J-Jappa/currawong/docs/media/photos/front-closeup.jpg

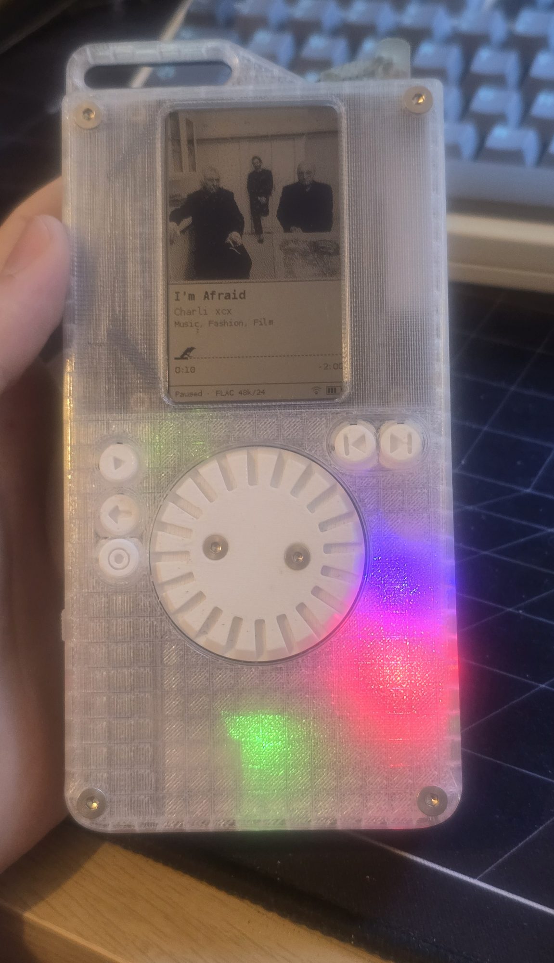
docs/media/photos/front-closeup.jpg
