J-Jappa/currawong/docs/media/photos/pcb-bare-front.jpg

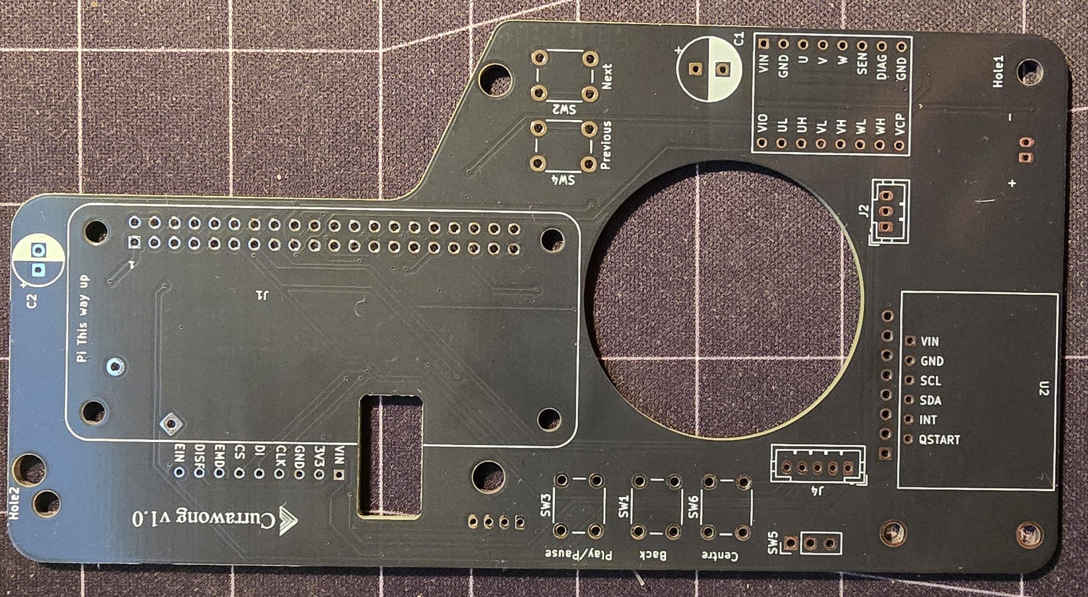
docs/media/photos/pcb-bare-front.jpg
