J-Jappa/currawong/pi/assets/branch_sway.png

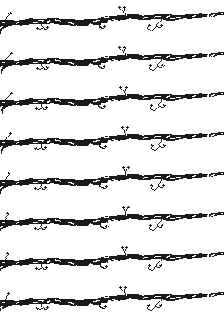
pi/assets/branch_sway.png
