J-Jappa/currawong/pi/assets/currawong_sheet.png

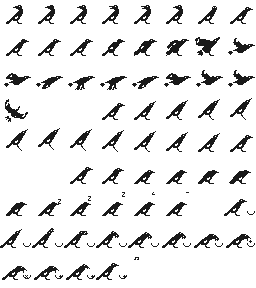
pi/assets/currawong_sheet.png
