J-Jappa/currawong/hardware/case/stl/Back Case v4.STL

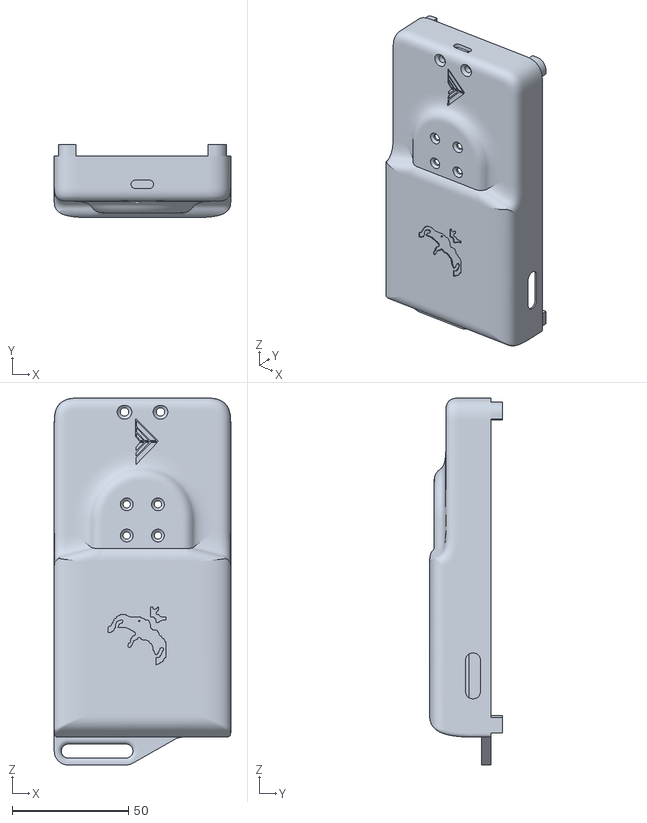
[picture p21: CAD file, 2026-10-29]
hardware/case/stl/Back Case v4.STL
76.0 x 31.4 x 158.0
