J-Jappa/currawong/hardware/logos/currawong-icon-x4.dxf

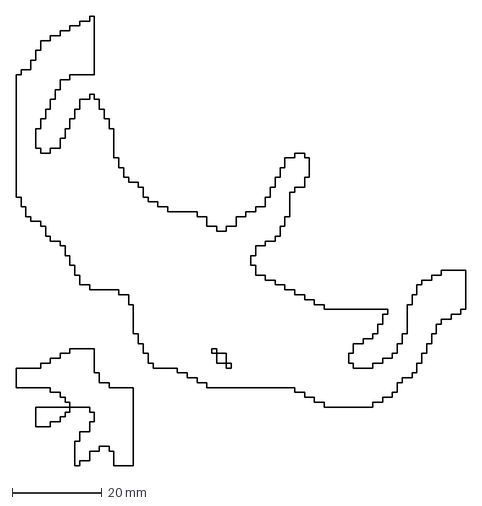
[picture p22: CAD file, 2026-10-29]
hardware/logos/currawong-icon-x4.dxf
100.0 x 100.0 mm
