J-Jappa/currawong/hardware/pcb/Currawong-v1.0.step

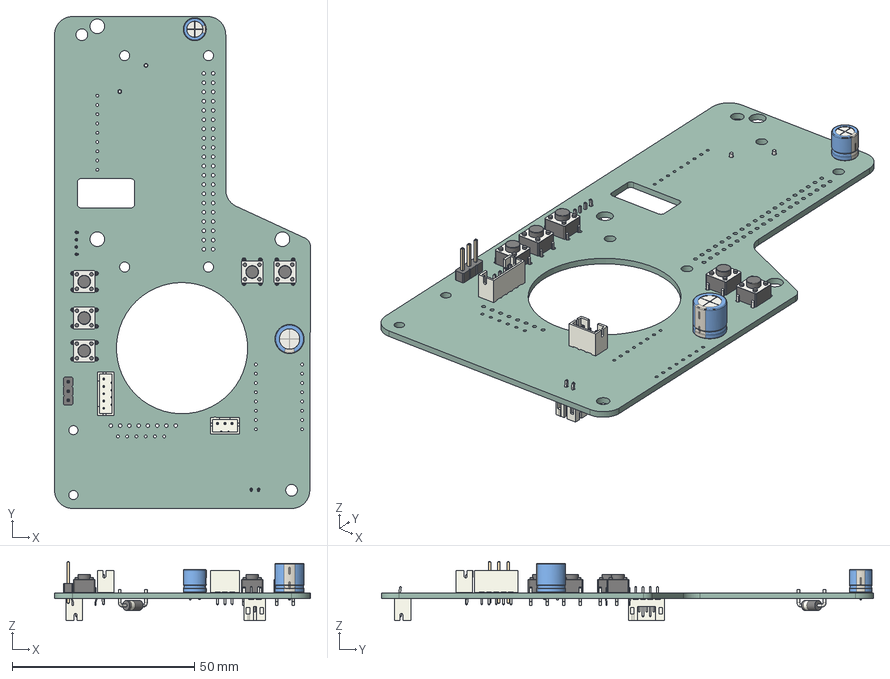
[picture p23: CAD file, 2026-10-29]
hardware/pcb/Currawong-v1.0.step
70.2 x 135.0 x 16.2 mm
SW_PUSH_6mm_h5mm x 5
JST_B5B_PH_K
CP_Radial_D63mm_P250mm
JST_B3B_PH_K
PinHeader_1x03_P254mm_Vertical
CP_Radial_D80mm_P350mm
D_DO-41_SOD81_P10.16mm_Horizontal
JST_B2B_PH_K
JST_B4B_PH_K
Cur1A55_PCB
