J-Jappa/currawong/hardware/case/solidworks/Button Center.SLDPRT

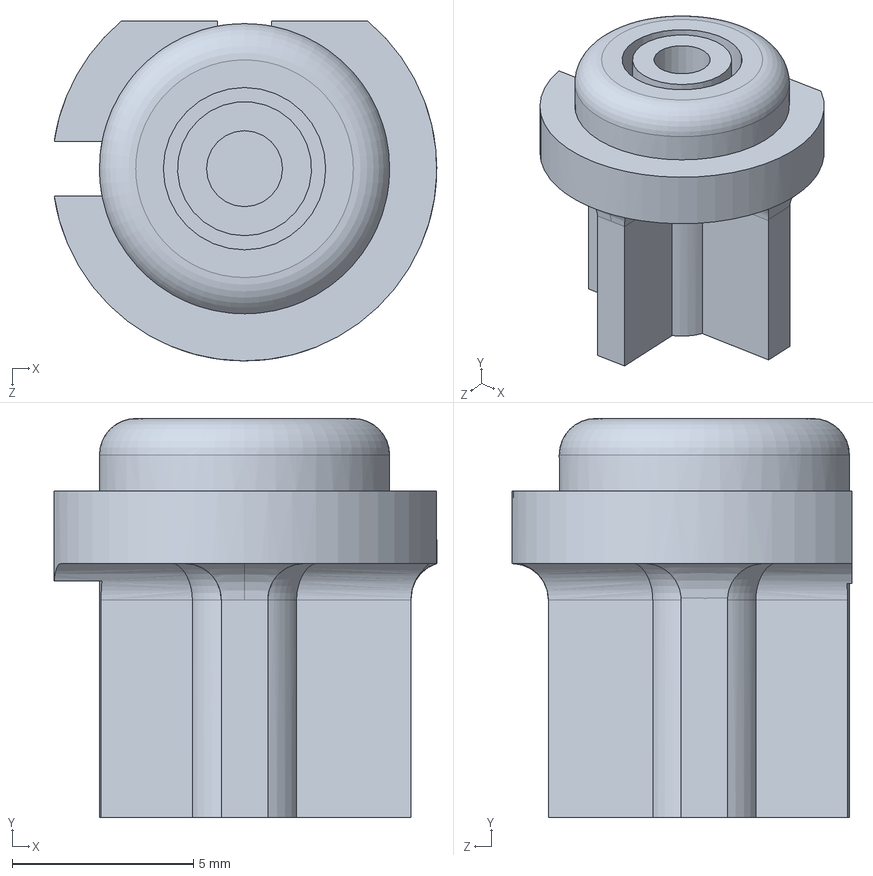
[picture p24: CAD file, 2026-10-29]
hardware/case/solidworks/Button Center.SLDPRT
10.5 x 11.0 x 9.37 mm
