J-Jappa/currawong/hardware/logos/personal-mark.dxf

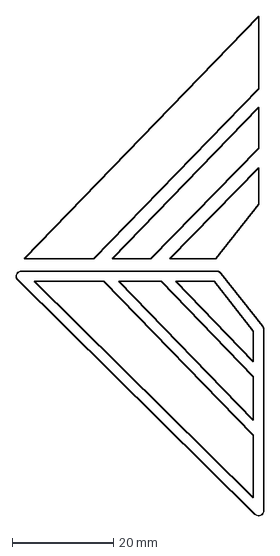
[picture p25: CAD file, 2026-10-29]
hardware/logos/personal-mark.dxf
48.8 x 98.4 mm
