J-Jappa/currawong/hardware/logos/currawong-icon-x2.dxf

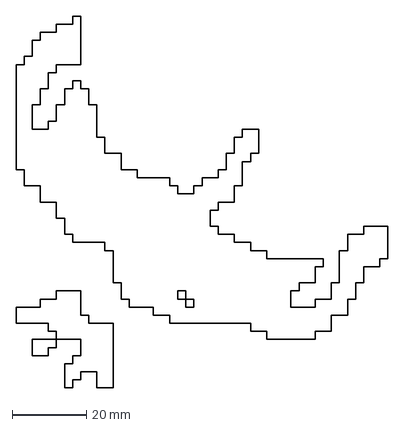
[picture p26: CAD file, 2026-10-29]
hardware/logos/currawong-icon-x2.dxf
100.0 x 100.0 mm
