J-Jappa/currawong/hardware/case/solidworks/Front Case v3.SLDPRT

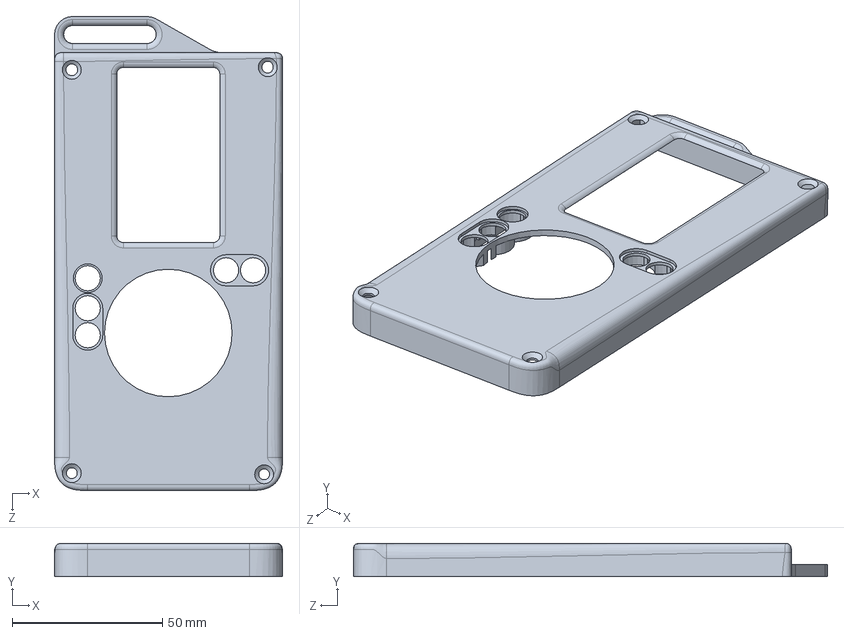
[picture p27: CAD file, 2026-10-29]
hardware/case/solidworks/Front Case v3.SLDPRT
76.0 x 11.0 x 158.0 mm
