J-Jappa/currawong/hardware/case/solidworks/Dial v2.SLDPRT

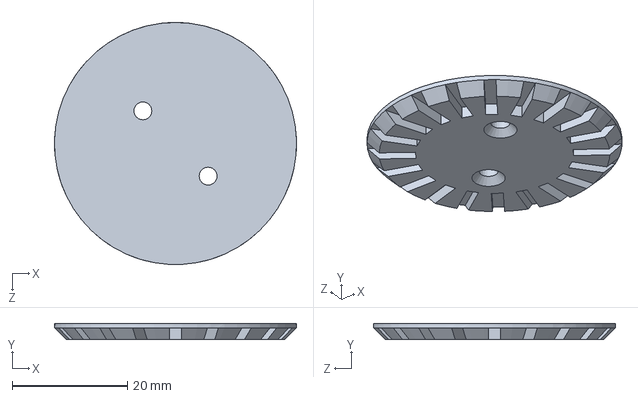
[picture p28: CAD file, 2026-10-29]
hardware/case/solidworks/Dial v2.SLDPRT
42.0 x 2.80 x 42.0 mm
