J-Jappa/currawong/hardware/case/solidworks/Button Next.SLDPRT

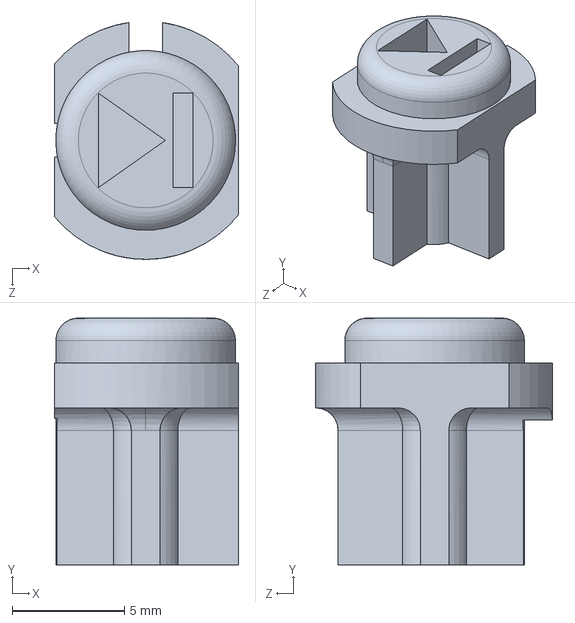
[picture p29: CAD file, 2026-10-29]
hardware/case/solidworks/Button Next.SLDPRT
8.21 x 11.0 x 10.5 mm
