J-Jappa/currawong/hardware/case/solidworks/Battery.SLDPRT

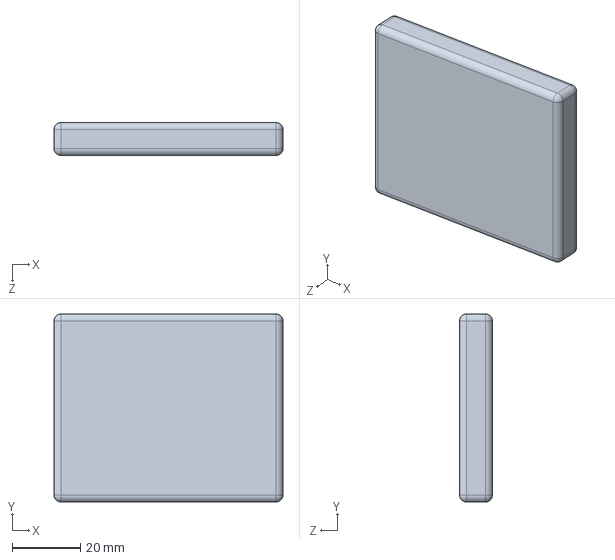
[picture p30: CAD file, 2026-10-29]
hardware/case/solidworks/Battery.SLDPRT
67.0 x 55.0 x 9.60 mm
