J-Jappa/currawong/hardware/case/solidworks/Display.SLDPRT

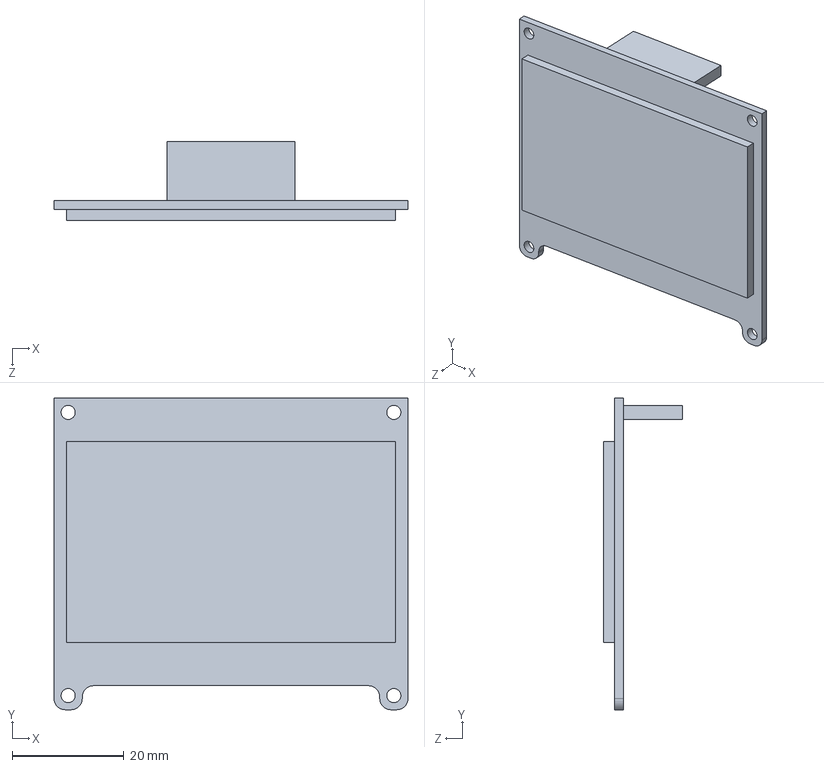
[picture p31: CAD file, 2026-10-29]
hardware/case/solidworks/Display.SLDPRT
63.5 x 55.9 x 14.3 mm
