J-Jappa/currawong/hardware/case/solidworks/Button Play.SLDPRT

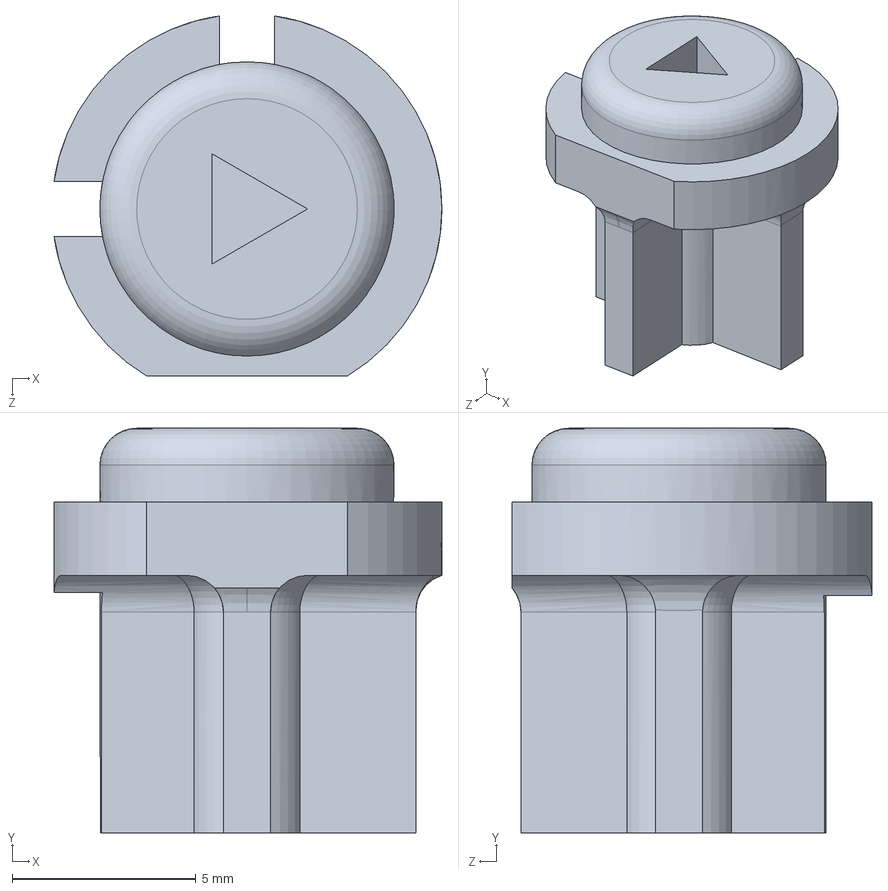
[picture p32: CAD file, 2026-10-29]
hardware/case/solidworks/Button Play.SLDPRT
10.5 x 11.0 x 9.79 mm
