J-Jappa/currawong/hardware/case/solidworks/Dac.SLDPRT

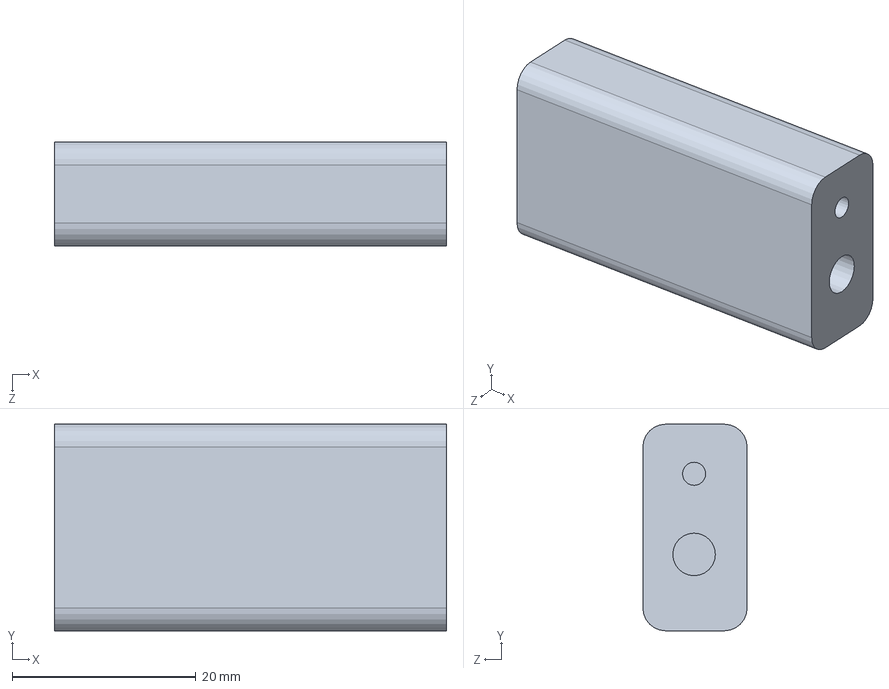
[picture p33: CAD file, 2026-10-29]
hardware/case/solidworks/Dac.SLDPRT
42.7 x 22.5 x 11.4 mm
