J-Jappa/currawong/hardware/case/solidworks/Slide Switch.SLDPRT

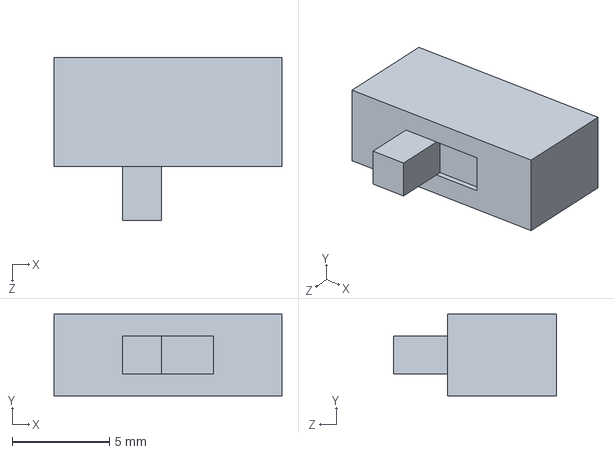
[picture p34: CAD file, 2026-10-29]
hardware/case/solidworks/Slide Switch.SLDPRT
11.7 x 4.20 x 8.36 mm
