J-Jappa/currawong/hardware/case/solidworks/Bad Slide Fix.SLDPRT

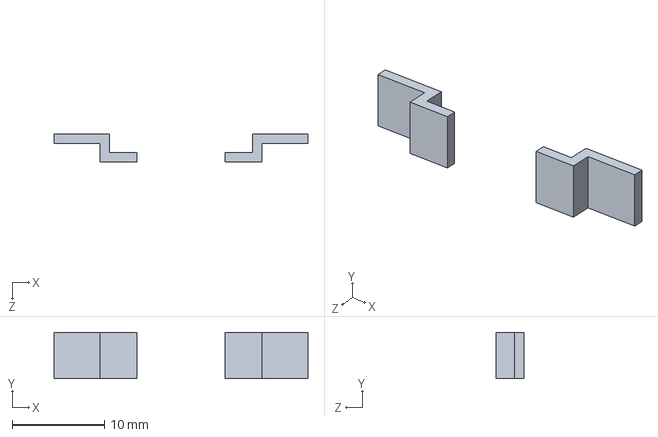
[picture p35: CAD file, 2026-10-29]
hardware/case/solidworks/Bad Slide Fix.SLDPRT
27.5 x 5.00 x 3.00 mm
