J-Jappa/currawong/hardware/case/solidworks/Button Back.SLDPRT

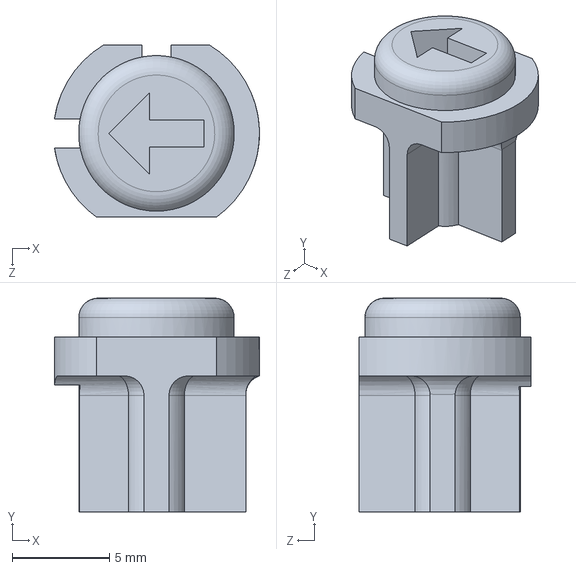
[picture p36: CAD file, 2026-10-29]
hardware/case/solidworks/Button Back.SLDPRT
10.5 x 11.0 x 8.84 mm
