J-Jappa/currawong/hardware/case/solidworks/Slide.SLDPRT

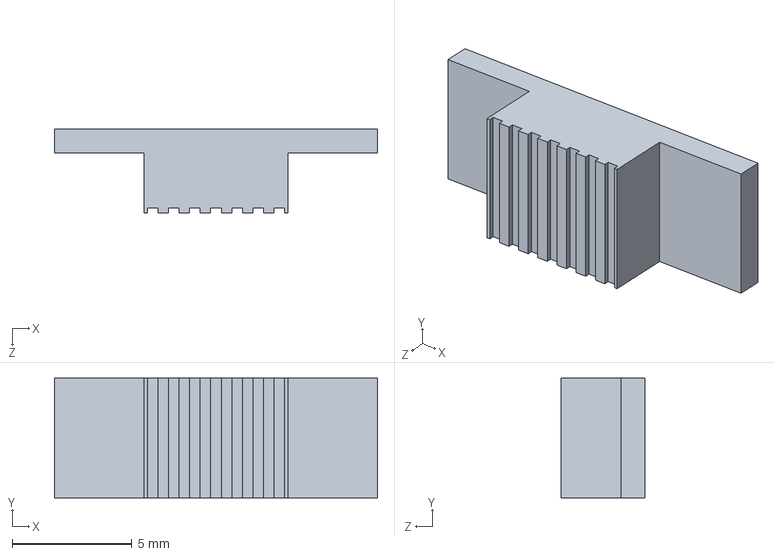
[picture p37: CAD file, 2026-10-29]
hardware/case/solidworks/Slide.SLDPRT
13.5 x 5.00 x 3.50 mm
