J-Jappa/currawong/hardware/case/solidworks/Currawong assembly.SLDASM

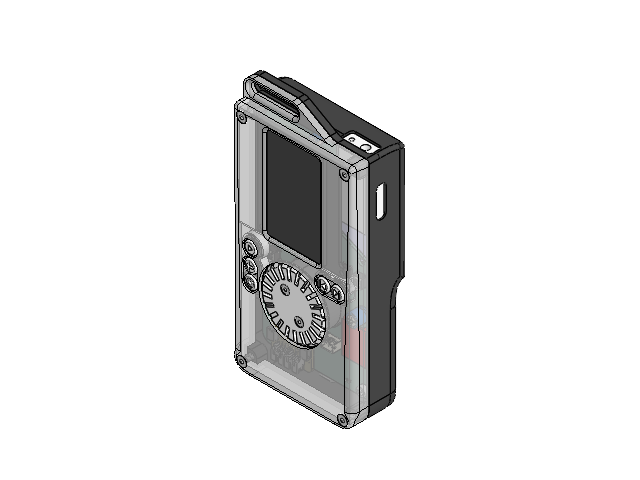
[picture p38: CAD file, 2026-10-29]
hardware/case/solidworks/Currawong assembly.SLDASM
SW_PUSH_6mm_h5mm_1.step x 5
JST_B5B_PH_K.step
CP_Radial_D63mm_P250mm.step
JST_B3B_PH_K.step
CP_Radial_D80mm_P350mm.step
D_DO-41_SOD81_P10.16mm_Horizontal-0.step
JST_B2B_PH_K.step
JST_B4B_PH_K.step
Cur1A55_PCB.step
Display
铜柱M2.5x7+4.STEP x 8
直流无刷电机HTY2804D3.STEP
AS5600磁编码器.STEP
Dial v2
Battery
Dac
Back Case v2
USB Breakout
Front Case v3
Button Play
Button Back
Button Center
Button Next
Button Previous
Slide Switch
Slide
Raspberry_pizero_PCB
Micro USB_input_female (short)-SMT x 2
0204 - Capacitor x 34
0204- Resistor x 17
CAP-0306 x 2
Raspberry_pizero_BCM2835 with VC4
Crystal 3.4x2.4mm
32,768 Khz Crystal
0805- Capacitor x 7
0204 - Capacitor Brown x 8
6-Pin SOT
micro sd molex
hdmi type C
Voltage Regulator 3x3mm 12-Pin
1210 inductor x 3
BOSS-EXTRUDE14_8__2.step
BOSS-EXTRUDE7_4__2.step
BOSS-EXTRUDE7_3__2.step
BOSS-EXTRUDE14_4__2.step
BOSS-EXTRUDE14_2__2.step
BOSS-EXTRUDE14_11__2.step
BOSS-EXTRUDE7_7__2.step
BOSS-EXTRUDE14_9__2.step
BOSS-EXTRUDE14_3__2.step
BOSS-EXTRUDE14_7__2.step
MIRROR2_2.step
BOSS-EXTRUDE14_5__2.step
BOSS-EXTRUDE14_12__2.step
BOSS-EXTRUDE7_8__2.step
BOSS-EXTRUDE7_1__2.step
BOSS-EXTRUDE14_10__2.step
BOSS-EXTRUDE7_9__2.step
BOSS-EXTRUDE14_6__2.step
CHAMFER9_2.step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
