J-Jappa/currawong/(list of files, cad)

Other CAD files:
hardware/case/solidworks/Back Case v2.SLDPRT
hardware/case/solidworks/Button Previous.SLDPRT
hardware/case/stl/Bad Slide Fix.STL
hardware/case/stl/Button Back.STL
hardware/case/stl/Button Center.STL
hardware/case/stl/Button Next.STL
hardware/case/stl/Button Play.STL
hardware/case/stl/Button Previous.STL
hardware/case/stl/Dial v2.STL
hardware/case/stl/Front Case v3.STL
hardware/case/stl/Slide.STL
