J-Jappa/currawong/hardware/pcb/Currawong.kicad_pcb

## KiCad design hardware/pcb/Currawong.kicad_pcb (2026-10-29)

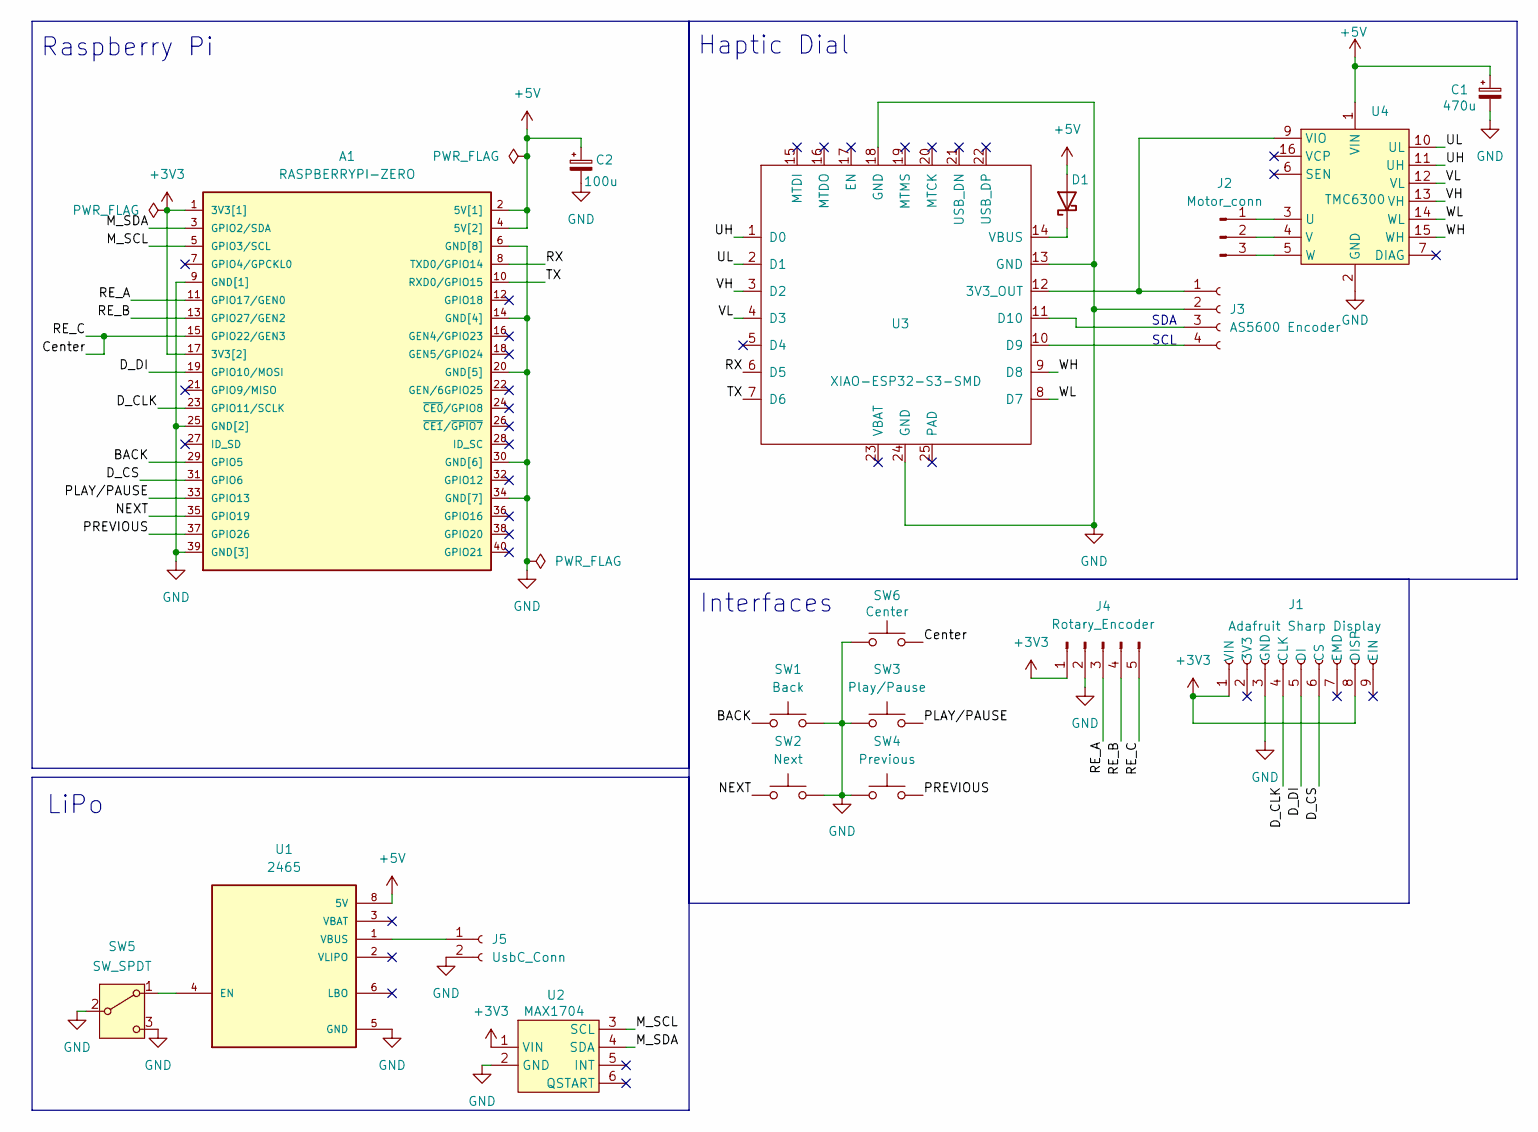
[picture p39: schematic Currawong.kicad_sch]

Parts:
A1: RASPBERRYPI-ZERO; RASPBERRYPI-ZERO_RPI-ZERO
C1: 470u; CP_Radial_D8.0mm_P3.50mm
C2: 100u; CP_Radial_D6.3mm_P2.50mm
D1: D_Schottky; D_DO-41_SOD81_P10.16mm_Horizontal
J1: Adafruit Sharp Display; Sharp_Display
J2: Motor_conn; JST_PH_B3B-PH-K_1x03_P2.00mm_Vertical
J3: AS5600 Encoder; JST_PH_B4B-PH-K_1x04_P2.00mm_Vertical
J4: Rotary_Encoder; JST_PH_B5B-PH-K_1x05_P2.00mm_Vertical
J5: UsbC_Conn; JST_PH_B2B-PH-K_1x02_P2.00mm_Vertical
SW1: Back; SW_PUSH_6mm_H5mm
SW2: Next; SW_PUSH_6mm_H5mm
SW3: Play/Pause; SW_PUSH_6mm_H5mm
SW4: Previous; SW_PUSH_6mm_H5mm
SW5: SW_SPDT; PinHeader_1x03_P2.54mm_Vertical
SW6: Center; SW_PUSH_6mm_H5mm
U1: 2465; MODULE_2465; PARTREV B
U2: MAX1704; AdaFruit_MAX17048
U3: XIAO-ESP32-S3-SMD
U4: TMC6300; Sparkfun_TMC6300

Connections:
+3V3: A1.1 (3V3[1]), A1.17 (3V3[2]), J1.1 (VIN), J1.8 (DISP), J4.1, U2.1 (VIN)
+5V: A1.2 (5V[1]), A1.4 (5V[2]), C1.1, C2.1, D1.2 (A), U1.8 (5V), U4.1 (VIN)
/BACK: A1.29 (GPIO5), SW1.1
/Center: A1.15 (GPIO22/GEN3), J4.5, SW6.2
/D_CLK: A1.23 (GPIO11/SCLK), J1.4 (CLK)
/D_CS: A1.31 (GPIO6), J1.6 (CS)
/D_DI: A1.19 (GPIO10/MOSI), J1.5 (DI)
/M_SCL: A1.5 (GPIO3/SCL), U2.3 (SCL)
/M_SDA: A1.3 (GPIO2/SDA), U2.4 (SDA)
/NEXT: A1.35 (GPIO19), SW2.1
/PLAY/PAUSE: A1.33 (GPIO13), SW3.2
/PREVIOUS: A1.37 (GPIO26), SW4.2
/RE_A: A1.11 (GPIO17/GEN0), J4.3
/RE_B: A1.13 (GPIO27/GEN2), J4.4
/RX: A1.8 (TXD0/GPIO14), U3.6 (D5)
/TX: A1.10 (RXD0/GPIO15), U3.7 (D6)
/UH: U3.1 (D0), U4.11 (UH)
/UL: U3.2 (D1), U4.10 (UL)
/VH: U3.3 (D2), U4.13 (VH)
/VL: U3.4 (D3), U4.12 (VL)
/WH: U3.9 (D8), U4.15 (WH)
/WL: U3.8 (D7), U4.14 (WL)
GND: A1.6 (GND[8]), A1.9 (GND[1]), A1.14 (GND[4]), A1.20 (GND[5]), A1.25 (GND[2]), A1.30 (GND[6]), A1.34 (GND[7]), A1.39 (GND[3]), C1.2, C2.2, J1.3 (GND), J3.2, J4.2, J5.2, SW1.2, SW2.2, SW3.1, SW4.1, SW5.2 (B), SW5.3 (C), SW6.1, U1.5 (GND), U1.7 (GND), U2.2 (GND), U3.13 (GND), U3.18 (GND), U3.24 (GND), U4.2 (GND), U4.8 (GND)
unnamed: D1.1 (K), U3.14 (VBUS)
unnamed: J2.1, U4.3 (U)
unnamed: J2.2, U4.4 (V)
unnamed: J2.3, U4.5 (W)
unnamed: J3.1, U3.12 (3V3_OUT), U4.9 (VIO)
unnamed: J3.3, U3.11 (D10)
unnamed: J3.4, U3.10 (D9)
unnamed: J5.1, U1.1 (VBUS)
unnamed: SW5.1 (A), U1.4 (EN)

Notes on the sheet:
LiPo
SDA
Raspberry Pi
Haptic Dial
SCL
Interfaces

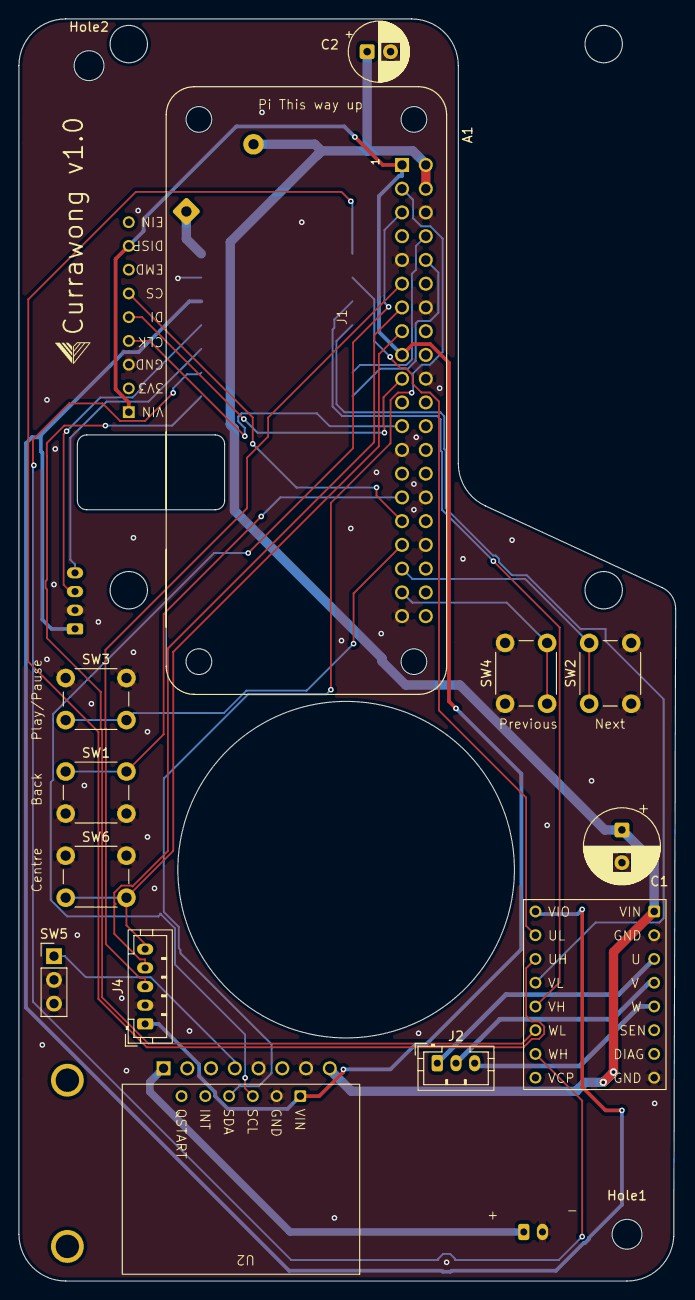
[picture p40: board Currawong.kicad_pcb from above]

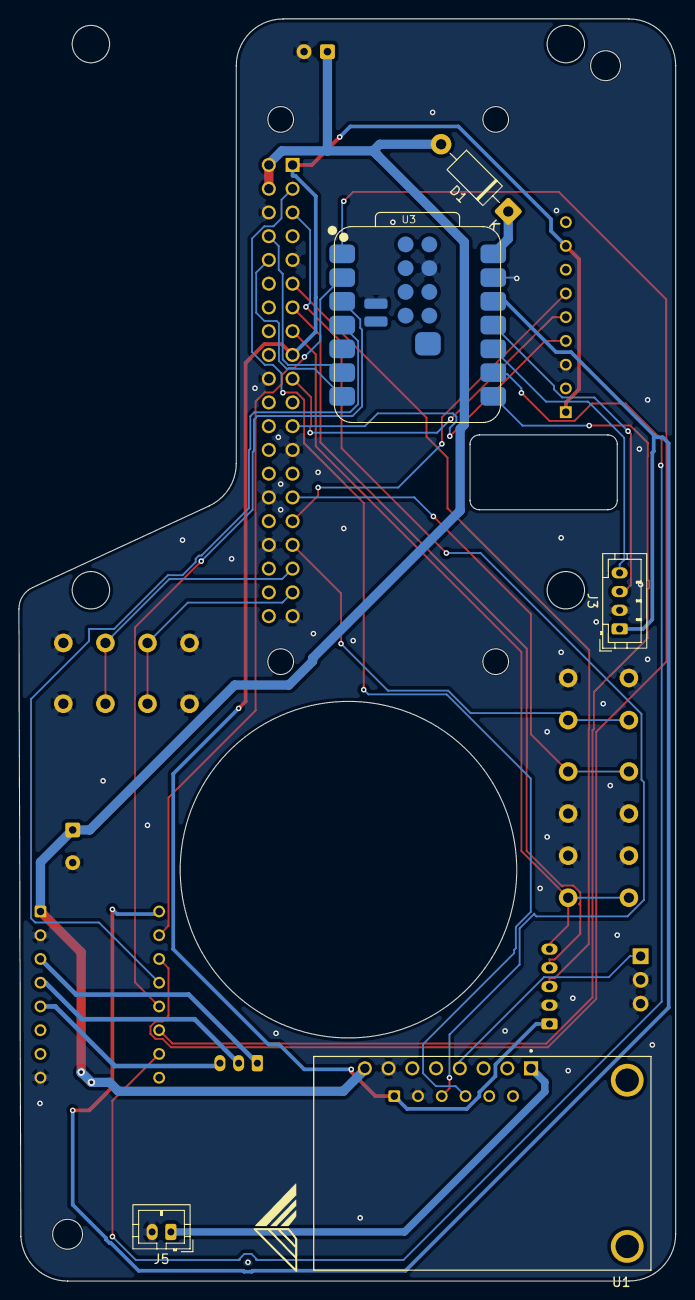
[picture p41: board Currawong.kicad_pcb from below]

Board: 2 copper layers, 70.2 x 135.0 mm, 23 parts (6 on the bottom side), 32 nets.

Other parts of the board:
Hole1, Hole2: MountingHole_3.2mm_M3
Logo1: LOGO; logo scaled 10mm
logo2: LOGO; logo scaled 5mm
