J-Jappa/currawong/pi/currawong_ui.py

#!/usr/bin/env python3
"""Currawong UI v10.

Two sources, chosen automatically by whichever is playing:

  SPOTIFY  (go-librespot)  simple screen: big cover, track info, progress.
  LOCAL    (MPD)           Now Playing with spectrum strips, plus the SCOPE page.

Menus: Library (artists, albums, playlists, up next), Spotify pinned playlists,
track options (shuffle, repeat, add to playlist), Bluetooth pairing, Wi-Fi
joining with an on-screen keyboard, audio output (wired or Bluetooth),
settings, about and power off.

Input: buttons and the EC11 on GPIO, plus the ESP32 haptic dial over UART
when it's connected (it then gets a feel for each screen: list detents with
end stops in menus, light scrub clicks on Now Playing). The dial spins a turn on
a track skip, rolls while you auto-scrub (hold next or previous), and can be
pocket-locked until the centre button is pressed.

Settings > Visuals: FULL (strips + Scope), REGULAR (strips, no Scope) or FAST
(no visuals, the lightest on a single-core Pi Zero W).

Rendering is event-driven: a screen is only redrawn when something on it
changes. Animation only runs for local playback in Active mode.

On the Pi:        python3 currawong_ui.py
Preview anywhere: python3 currawong_ui.py --preview   (writes PNGs, no hardware)
Profile on the Pi: python3 currawong_ui.py --profile 60   (writes ~/currawong/profile.txt)
"""
import atexit
import http.client
import json
import math
import os
import queue
import re
import select
import shutil
import signal
import socket
import subprocess
import sys
import threading
import time
import urllib.error
import urllib.request
from collections import Counter, deque
from io import BytesIO

import struct

CACHE_DIR = os.path.expanduser("~/.cache/currawong")
EARLY_SETTINGS_FILE = os.path.expanduser("~/.config/currawong/settings.json")
BOOT_WINDOW_SECS = 180   # the animation plays at boot; a restart later just shows the last frame


def splash_file(rot):
    return os.path.join(CACHE_DIR, f"splash_{rot}.bin")


def boot_anim_file(rot):
    return os.path.join(CACHE_DIR, f"boot_anim_{rot}.bin")


def _saved_rotation():
    """The screen's rotation from settings.json, read with nothing but the standard library."""
    try:
        with open(EARLY_SETTINGS_FILE) as f:
            saved = json.load(f)
        if saved.get("settings_v", 1) < 2:  # from before 270 became the default (see load_settings)
            return 270
        return 90 if saved.get("rotate") == 90 else 270
    except Exception:  # noqa: BLE001
        return 270


def _system_uptime():
    try:
        with open("/proc/uptime") as f:
            return float(f.read().split()[0])
    except (OSError, ValueError, IndexError):
        return 1e9


def _read_boot_anim(path):
    """(fps, [packet]) from the panel-ready cache that build_boot_anim() writes."""
    with open(path, "rb") as f:
        data = f.read()
    if data[:8] != b"CRWBOOT1":
        raise ValueError("not a boot animation")
    fps, count = struct.unpack_from("<HI", data, 8)
    off, packets = 14, []
    for _ in range(count):
        (n,) = struct.unpack_from("<I", data, off)
        off += 4
        packets.append(bytearray(data[off:off + n]))
        off += n
    return fps, packets


class _BootAnimation(threading.Thread):
    """Plays the boot animation once, straight to the panel, then holds its last frame (keeping
    VCOM toggling, as the panel needs) until main() takes the display over. Each packet is one
    frame's changed panel lines, built by build_boot_anim(), so this needs no PIL."""

    def __init__(self, fps, packets, spi, lg, h):
        super().__init__(name="boot-anim", daemon=True)
        self.fps, self.packets, self.spi, self.lg, self.h = fps, packets, spi, lg, h
        self.vcom, self.flip_at = False, 0.0
        self.played = threading.Event()   # set once the last frame is up
        self.release = threading.Event()  # set by main() to take over the display

    def _vbit(self, now, force=False):
        if force or now >= self.flip_at:  # VCOM flips twice a second
            self.vcom, self.flip_at = not self.vcom, now + 0.5
        return 0x40 if self.vcom else 0x00

    def _send(self, buf):
        self.lg.gpio_write(self.h, 6, 1)
        self.spi.writebytes2(buf)
        self.lg.gpio_write(self.h, 6, 0)

    def run(self):
        try:
            start, dt = time.monotonic(), 1.0 / self.fps
            for i, pkt in enumerate(self.packets):
                now = time.monotonic()
                if pkt:
                    pkt[0] = 0x80 | self._vbit(now)
                    self._send(pkt)
                elif now >= self.flip_at:
                    self._send(bytes([self._vbit(now), 0]))
                wait = start + (i + 1) * dt - time.monotonic()
                if wait > 0:
                    time.sleep(wait)
        except Exception:  # noqa: BLE001 - a hiccup must never stop the UI starting
            pass
        finally:
            self.played.set()
        while not self.release.wait(0.5):
            try:
                self._send(bytes([self._vbit(time.monotonic(), force=True), 0]))
            except Exception:  # noqa: BLE001
                break


_BOOT = None  # the boot animation while it plays; main() takes the display over from it


def _early_display():
    """The moment the service starts, before the slow imports below (PIL and the rest of this
    file): at boot, play the animation; on a later restart, show its last frame. Both replay
    bytes saved by an earlier run. Any problem: skip quietly, main() draws the splash itself."""
    global _BOOT
    rot = _saved_rotation()
    anim = frame = None
    if _system_uptime() < BOOT_WINDOW_SECS:
        try:
            anim = _read_boot_anim(boot_anim_file(rot))
        except Exception:  # noqa: BLE001 - not built yet (first run): the still splash instead
            anim = None
    try:
        if anim is None:
            with open(splash_file(rot), "rb") as f:
                frame = f.read()
        import lgpio
        import spidev
        h = lgpio.gpiochip_open(0)
        lgpio.gpio_claim_output(h, 6, 0)  # CS_PIN, active-high
        spi = spidev.SpiDev()
        spi.open(0, 0)
        spi.max_speed_hz, spi.mode = 2_000_000, 0
        if anim is not None:
            _BOOT = _BootAnimation(anim[0], anim[1], spi, lgpio, h)
            _BOOT.start()
            return
        try:
            lgpio.gpio_write(h, 6, 1)
            spi.writebytes2(frame)
            lgpio.gpio_write(h, 6, 0)
            spi.close()
        finally:
            lgpio.gpio_free(h, 6)
            lgpio.gpiochip_close(h)
    except Exception:  # noqa: BLE001 - a missing logo must never stop the UI starting
        pass


if __name__ == "__main__" and os.environ.get("CURRAWONG_EARLY_SPLASH") == "1":
    _early_display()


class _LazyNumpy:
    """numpy takes seconds to load on a Zero W and the first screen doesn't need it, so it loads
    on first use (main() starts that in the background once the first screen is up)."""

    def __getattr__(self, name):
        global np
        try:
            import numpy
        except ImportError:
            sys.exit("numpy is missing: sudo apt install -y python3-numpy")
        np = numpy
        return getattr(numpy, name)


np = _LazyNumpy()

from PIL import Image, ImageDraw, ImageFont, ImageOps

# ======================================================================
# Settings
# ======================================================================
API_HOST, API_PORT = "127.0.0.1", 3678   # go-librespot (it listens on 127.0.0.1 only)
API = f"http://{API_HOST}:{API_PORT}"
MPD_HOST, MPD_PORT = "localhost", 6600
MPD_FIFO = "/tmp/currawong.fifo"         # MPD fifo output, format "22050:16:2" (the old way)
LOOPBACK_CAPTURE = "hw:Loopback,1,0"     # the Visualiser output's copy, via the ALSA loopback (snd-aloop)
RATE = 22050
MPD_ANY_SONG = '(file != "")'          # an MPD filter matching every song (with "window 0:1": just one)
MPD_OUTPUT_VIS = "Visualiser"            # MPD's output feeding the loopback (switched on only when needed)
VIS_OFF_DELAY = 10.0      # the analyser idle this long: switch MPD's Visualiser output off
TAP_POLL = 0.1            # capture reads check every this long whether they're still wanted
TAP_STALL_SECS = 4.0      # no samples this long while wanted: restart the capture

ROTATE = 270              # 90 or 270, depending on which way the panel sits
FPS_ACTIVE = 5            # local Now Playing frame rate while Active
FPS_SCOPE = 1             # Scope page frame rate while Active (it redraws everything)
VISUALS = ["FULL", "REGULAR", "FAST"]  # Settings > Visuals: strips + Scope / strips only / none
SCRUB_SPEEDS = [4, 8, 16, 32]   # auto-scrub: times normal speed; each extra press goes up one
ROLL_RATES = [0.25, 0.45, 0.7, 1.0]   # dial turns per second at each of those speeds
SCRUB_TICK = {"local": 0.25, "spotify": 0.6}   # seconds between jumps (Spotify rebuffers on each)
SHUTTLE_GEARS = [(12, 0), (30, 2), (50, 4), (70, 8), (88, 16)]  # shuttle: twist (of 100) below -> speed; beyond: 32x
RANGE_SYNC_SECS = 2.0     # how often the dial's song walls follow playback while it's left alone
BATTERY_MAH = 2000        # default capacity, for the drain estimate (Settings > Advanced > Battery)
WIFI_SAVER_SECS = 300     # Wi-Fi saver: radio off after this long without Spotify playing
ENC_REVERSE = False       # flip if the encoder turns the wrong way
SPOTIFY_FORMAT = "OGG 320k"
UI_BUILD = "2026-10-24l"   # shown in ABOUT, logged at start, and by --version: which file is running
SERIAL_PORT, SERIAL_BAUD = "/dev/serial0", 115200   # ESP32 haptic dial link
LIBRESPOT_CONFIG = os.path.expanduser("~/.config/go-librespot/config.yml")
WIRED_DEVICE = "currawong_dac"    # /etc/asound.conf: the DAC, through the equaliser when installed
BT_DEVICE = "bt"                 # ALSA PCM for bluez-alsa, defined in /etc/asound.conf
DAC_CARD = "PRO2"                # the DAC's ALSA card ID, for its hardware volume (if it has one)
MPD_OUTPUT_WIRED, MPD_OUTPUT_BT = "DAC", "Bluetooth"
PINS_FILE = os.path.expanduser("~/.config/currawong/spotify_pins.json")

PINS = dict(enc_a=17, enc_b=27, enc_sw=22, back=5, play=13, next=19, prev=26)
CS_PIN = 6
LBO_PIN = None            # set to 16 once PowerBoost LBO is wired (10k series resistor)
LOW_BATT_SHUTDOWN_SECS = 60   # charge at or below BATT_SOC_LOW this long: switch off (unless surely charging)
BATT_SOC_LOW = 5               # %
BATT_SOC_TRUST_VOLTS = 3.80    # a charge that low while the cell is above this isn't believed (gauge settling)
BATT_CUTOFF_VOLTS = 3.30       # default voltage cutoff (setting "cutoff_volts", 3.0-3.6)
BATT_VOLT_HOLD_SECS = 30       # the cell's median voltage below the cutoff this long: switch off
BATT_CRITICAL_VOLTS = 3.10     # below this the boost is near its limit: switch off sooner
BATT_CRITICAL_HOLD_SECS = 5
BATT_VOLT_WINDOW_SECS = 12     # the median's window (a motor kick lasts a fraction of a second)
BATT_VOLT_HYST = 0.05          # the voltage timer clears only this far above the cutoff
BATT_STALE_SECS = 60           # a gauge silent this long: level unknown
BATT_VOLTS_SANE = (2.5, 4.6)   # readings outside this are glitches

ANALYSIS_FPS = 5
NFFT = 2048
HISTORY = 50              # analysis frames kept (10 s at 5 fps)

LOGO_FILE = os.path.expanduser("~/currawong/logo.png")  # optional: replaces the placeholder logo
SETTINGS_FILE = os.path.expanduser("~/.config/currawong/settings.json")
DEFAULT_SETTINGS = {"active_secs": 30, "sleep_secs": 180, "output": "wired",
                    "haptics": 1, "feel": 100, "rotate": ROTATE, "auto_off_mins": 30,
                    "visuals": 1, "scrub_step": 2, "skip_spin": 1, "pocket_secs": 0, "dial_dir": 1,
                    "scrub_style": "clicks", "wifi_saver": 0,
                    "eq": {"preset": "FLAT", "gains": [0, 0, 0, 0, 0]}, "resume": "ready", "click": 30,
                    "battery_mah": BATTERY_MAH, "cutoff_volts": BATT_CUTOFF_VOLTS}
POLL_EVERY = {"active": 1.0, "glance": 1.0, "sleep": 5.0}

STATUS = {"wifi": None, "radio": True, "output": "wired", "locked": False, "scrub": ""}   # shared with every screen

W, H = 240, 400           # portrait canvas
PANEL_W, PANEL_H = 400, 240
BLACK, WHITE = 0, 1

_T = getattr(Image, "Transpose", Image)
_R = getattr(Image, "Resampling", Image)

FONT_DIR = "/usr/share/fonts/truetype/dejavu/"


def _font(name, size):
    try:
        return ImageFont.truetype(FONT_DIR + name, size)
    except OSError:
        return ImageFont.load_default()


F_TINY = _font("DejaVuSansMono.ttf", 10)
F_SMALL = _font("DejaVuSansMono.ttf", 11)
F_BODY = _font("DejaVuSansMono.ttf", 13)
F_BOLD = _font("DejaVuSansMono-Bold.ttf", 13)
F_SBOLD = _font("DejaVuSansMono-Bold.ttf", 11)
F_BIG = _font("DejaVuSansMono-Bold.ttf", 16)
F_HUGE = _font("DejaVuSansMono-Bold.ttf", 20)


# ======================================================================
# Text and drawing helpers
# ======================================================================
def tlen(font, text):
    return font.getlength(text)


def fit(text, font, max_w):
    """Trim text with an ellipsis so it fits in max_w pixels."""
    if tlen(font, text) <= max_w:
        return text
    while text and tlen(font, text + "…") > max_w:
        text = text[:-1]
    return text.rstrip() + "…"


def wrap(text, font, max_w, max_lines):
    """Greedy word wrap into at most max_lines, ellipsis on overflow."""
    words = text.split()
    lines, i = [], 0
    while i < len(words) and len(lines) < max_lines:
        line = words[i]
        i += 1
        while i < len(words) and tlen(font, line + " " + words[i]) <= max_w:
            line += " " + words[i]
            i += 1
        lines.append(line)
    if i < len(words) and lines:
        lines[-1] = fit(lines[-1] + " " + " ".join(words[i:]), font, max_w)
    return [fit(line, font, max_w) for line in lines]


_TEXT_CACHE = {}


def text_mask(text, font):
    """1-bit mask of rendered text, cached. Rendering glyphs is the slow part on a Zero W."""
    key = (text, id(font))
    m = _TEXT_CACHE.get(key)
    if m is None:
        if len(_TEXT_CACHE) > 3000:
            _TEXT_CACHE.clear()
        x0, y0, x1, y1 = font.getbbox(text) if text else (0, 0, 0, 0)
        m = Image.new("1", (max(1, int(x1) + 1), max(1, int(y1) + 1)), 0)
        if text:
            ImageDraw.Draw(m).text((0, 0), text, font=font, fill=1)
        _TEXT_CACHE[key] = m
    return m


class CDraw:
    """ImageDraw wrapper whose text() pastes cached glyph masks (identical output, much faster)."""

    def __init__(self, img):
        self.img = img
        self.d = ImageDraw.Draw(img)

    def text(self, xy, text, font=None, fill=BLACK, **kw):
        if self.img.mode != "1" or kw:
            return self.d.text(xy, text, font=font, fill=fill, **kw)
        m = text_mask(text, font)
        self.img.paste(fill, (int(round(xy[0])), int(round(xy[1]))), m)

    def __getattr__(self, name):
        return getattr(self.d, name)


def Draw(img):
    return CDraw(img)


def label(d, x, y, text, font=None):
    """Small label on a white plate, drawn over busy content."""
    font = font or F_TINY
    tw = tlen(font, text)
    d.rectangle((x - 1, y - 1, x + tw + 1, y + 11), fill=WHITE)
    d.text((x, y), text, font=font, fill=BLACK)


def centred(d, cx, y, text, font):
    d.text((cx - tlen(font, text) / 2, y), text, font=font, fill=BLACK)


def hatch(w, h, step=5):
    im = Image.new("1", (w, h), WHITE)
    d = ImageDraw.Draw(im)
    for x in range(-h, w + h, step):
        d.line((x, h - 1, x + h, 0), fill=BLACK, width=2)
    d.rectangle((0, 0, w - 1, h - 1), outline=BLACK)
    return im


def dots(w, h):
    im = Image.new("1", (w, h), WHITE)
    px = im.load()
    for y in range(1, h, 4):
        for x in range(1 + ((y // 4) % 2) * 2, w, 4):
            px[x, y] = BLACK
    return im


def titled(title):
    img = Image.new("1", (W, H), WHITE)
    d = Draw(img)
    d.rectangle((0, 0, W - 1, 27), fill=BLACK)
    d.text((8, 6), title, font=F_BIG, fill=WHITE)
    return img, d


_TWIG = []


def twig(img, frac):
    """The progress bar as the bird's twig (currawong_bird.draw_twig); the plain bar if the bird's
    module isn't there. Returns the playhead's x."""
    if not _TWIG:
        try:
            from currawong_bird import draw_twig
            _TWIG.append(draw_twig)
        except ImportError:
            _TWIG.append(None)
    if _TWIG[0]:
        try:
            return _TWIG[0](img, frac)
        except Exception:  # noqa: BLE001
            _TWIG[0] = None    # the plain bar from now on
    d = Draw(img)
    d.rectangle((8, 338, W - 9, 344), outline=BLACK)
    end = 9 + int((W - 19) * max(0.0, min(1.0, frac)))
    d.rectangle((9, 339, end, 343), fill=BLACK)
    return end


BIRD_TICK = 0.125   # the currawong's tick: 8 fps (currawong_bird.TICK)
PAUSED_IDLE_SECS = 60   # paused this long with nothing touched: Home shows the bird's branch


def bird_columns(boxes):
    """Merge boxes (x0, y0, x1, y1) into the column ranges the display refreshes."""
    spans = sorted((max(0, int(b[0])), min(W, int(b[2]))) for b in boxes if b)
    out = []
    for a, b in spans:
        if out and a <= out[-1][1]:
            out[-1] = (out[-1][0], max(out[-1][1], b))
        elif a < b:
            out.append((a, b))
    return out


def mmss(ms):
    s = int(ms // 1000)
    return f"{s // 60}:{s % 60:02d}"


def dither(raw, size):
    """Album art -> 1-bit, Floyd-Steinberg dithered, with an auto-contrast pass."""
    im = Image.open(BytesIO(raw))
    im.draft("L", (size * 2, size * 2))  # fast JPEG decode at reduced scale
    im = im.convert("L")
    im = ImageOps.fit(im, (size, size), _R.LANCZOS)
    im = ImageOps.autocontrast(im, cutoff=2)
    return im.convert("1")


def make_covers(raw):
    return {"small": dither(raw, 104), "large": dither(raw, 240)}


def stipple_mask(h, w):
    """Diamond dot lattice used for stippled fills."""
    y, x = np.mgrid[0:h, 0:w]
    return ((y % 4 == 0) & (x % 4 == 0)) | ((y % 4 == 2) & (x % 4 == 2))


# ======================================================================
# Logo and power screens
# ======================================================================
def placeholder_logo(size):
    """Simple bird mark, drawn large in greyscale then reduced for clean 1-bit edges."""
    S = size * 4
    im = Image.new("L", (S, S), 255)
    d = ImageDraw.Draw(im)
    u, c = S / 100, S / 2

    def p(x, y):
        return (c + x * u, c + y * u)

    w2, w3 = max(1, int(2 * u)), max(1, int(3 * u))
    d.ellipse([p(-46, -46), p(46, 46)], outline=0, width=w3)
    d.polygon([p(-20, 4), p(-44, 24), p(-38, 30), p(-16, 14)], fill=0)        # tail
    d.ellipse([p(-26, -8), p(20, 18)], fill=0)                                  # body
    d.ellipse([p(10, -22), p(32, 0)], fill=0)                                   # head
    d.polygon([p(29, -15), p(45, -8), p(29, -6)], fill=0)                       # beak
    d.ellipse([p(-6, 0), p(8, 8)], fill=255)                                    # wing patch
    d.polygon([p(-41, 25), p(-44, 24), p(-38, 30), p(-35, 28)], fill=255)       # tail tip
    d.ellipse([p(20, -15), p(26, -9)], fill=255)                                # eye
    d.line([p(-2, 17), p(-4, 30)], fill=0, width=w2)                            # legs
    d.line([p(6, 17), p(6, 30)], fill=0, width=w2)
    d.line([p(-30, 30), p(34, 30)], fill=0, width=w2)                           # perch
    im = im.resize((size, size), _R.LANCZOS)
    return im.point(lambda v: 255 if v > 128 else 0).convert("1")


def logo_image(size):
    """Your own logo from LOGO_FILE if it exists, otherwise the placeholder."""
    try:
        im = Image.open(LOGO_FILE).convert("L")
        im = ImageOps.contain(im, (size, size), _R.LANCZOS)
        return im.convert("1")
    except Exception:
        return placeholder_logo(size)


ANIM_FILE = os.path.expanduser("~/currawong/currawong_boot.anim")
_INVERT = bytes(255 - i for i in range(256))   # the animation's 1 = ink; PIL's 1 = white
_HOLD = None


def read_anim_asset(path=None, frames=True):
    """(meta, hold frame bytes, all frames bytes or None) from currawong_boot.anim."""
    import zlib
    with open(path or ANIM_FILE, "rb") as f:
        data = f.read()
    if data[:8] != b"CRWANIM1":
        raise ValueError("not a Currawong animation")
    (n,) = struct.unpack_from("<I", data, 8)
    meta = json.loads(data[12:12 + n])
    off = 12 + n
    hold = data[off:off + meta["bpf"]]
    return meta, hold, (zlib.decompress(data[off + meta["bpf"]:]) if frames else None)


def anim_image(raw, meta):
    return Image.frombytes("1", (meta["w"], meta["h"]), raw.translate(_INVERT))


def hold_image():
    """The animation's last frame: the currawong on the wordmark, the personal mark below. None
    without the animation file."""
    global _HOLD
    if _HOLD is None:
        try:
            meta, hold, _ = read_anim_asset(frames=False)
            _HOLD = anim_image(hold, meta)
        except Exception:  # noqa: BLE001
            _HOLD = False
    return _HOLD or None


def brand_parts():
    """(lockup, mark) cut from the last frame: the bird on the wordmark, and the personal mark."""
    hold = hold_image()
    if hold is None:
        return None, None
    ink = ImageOps.invert(hold.convert("L"))
    top = ink.crop((0, 0, W, H * 3 // 5)).getbbox()
    low = ink.crop((0, H * 3 // 5, W, H)).getbbox()
    lockup = hold.crop(top) if top else None
    mark = hold.crop((low[0], low[1] + H * 3 // 5, low[2], low[3] + H * 3 // 5)) if low else None
    return lockup, mark


def splash_screen():
    """What shows while the UI starts: the animation's last frame, or the drawn logo without it."""
    hold = hold_image()
    return hold.copy() if hold is not None else logo_screen()


def logo_screen(text=None, sub=None, note=()):
    img = Image.new("1", (W, H), WHITE)
    d = Draw(img)
    logo = logo_image(140)
    img.paste(logo, ((W - logo.width) // 2, 100))
    if text:
        centred(d, W / 2, 262, text, F_BIG)
    if sub:
        centred(d, W / 2, 286, sub, F_SMALL)
    for n, line in enumerate(note):
        centred(d, W / 2, 330 + n * 16, line, F_SMALL)
    return img


def powered_off_screen(reason=None):
    # The Pi has halted, but the boost converter still powers it until the switch goes off.
    notes = ("Slide the switch off.", "Switch on again to start.")
    hold = hold_image()
    if hold is None:
        return logo_screen("POWERED OFF", reason, notes)
    img = hold.copy()   # the lockup sits above, the mark below; the words go in the gap and under
    d = Draw(img)
    centred(d, W / 2, 230, "POWERED OFF", F_BIG)
    if reason:
        centred(d, W / 2, 252, reason, F_SMALL)
    for n, line in enumerate(notes):
        centred(d, W / 2, 346 + n * 16, line, F_SMALL)
    return img


def system_stopping():
    """True while the whole system is shutting down (not just this service restarting)."""
    try:
        out = subprocess.run(["systemctl", "is-system-running"], capture_output=True,
                             text=True, timeout=2).stdout.strip()
        return out == "stopping"
    except Exception:
        return False


# ======================================================================
# Settings persistence
# ======================================================================
SETTINGS_V = 2   # 2: the panel now sits the other way, so 270 is the default rotation


def load_settings():
    s = dict(DEFAULT_SETTINGS)
    try:
        with open(SETTINGS_FILE) as f:
            saved = json.load(f)
        if saved.get("settings_v", 1) < 2:
            saved["rotate"] = 270  # saved before the panel was turned round
        if "feel" not in saved:   # from when the dial's strength was LIGHT/MEDIUM/STRONG
            saved["feel"] = {0: 70, 1: 100, 2: 130}.get(saved.get("haptics", 1), 100)
        s.update(saved)
    except Exception:
        pass
    s["settings_v"] = SETTINGS_V
    return s


def save_settings(s):
    try:
        os.makedirs(os.path.dirname(SETTINGS_FILE), exist_ok=True)
        with open(SETTINGS_FILE, "w") as f:
            json.dump(s, f)
    except Exception:
        pass


# ======================================================================
# Display driver (Sharp memory LCD over spidev)
# ======================================================================
def _rev(b):
    return int(f"{b:08b}"[::-1], 2)


class _LgpioPin:
    """An output pin straight through lgpio: much quicker to set up than gpiozero on a Zero W,
    which matters because it's the first thing the UI does."""

    def __init__(self, pin):
        import lgpio
        self.lg, self.pin = lgpio, pin
        self.h = lgpio.gpiochip_open(0)
        lgpio.gpio_claim_output(self.h, pin, 0)

    @classmethod
    def adopt(cls, lg, h, pin):
        """Take over a pin the boot animation already claimed."""
        p = cls.__new__(cls)
        p.lg, p.h, p.pin = lg, h, pin
        return p

    def on(self):
        self.lg.gpio_write(self.h, self.pin, 1)

    def off(self):
        self.lg.gpio_write(self.h, self.pin, 0)


class SharpDisplay:
    def __init__(self, spi=None, cs=None):
        if spi is None:
            import spidev

            spi = spidev.SpiDev()
            spi.open(0, 0)
            spi.max_speed_hz = 2_000_000
            spi.mode = 0
            try:
                cs = _LgpioPin(CS_PIN)
            except Exception:  # noqa: BLE001 - no lgpio: gpiozero does the same job, just slower
                from gpiozero import DigitalOutputDevice
                cs = DigitalOutputDevice(CS_PIN, active_high=True, initial_value=False)
        self.spi, self.cs = spi, cs
        self.addr = [_rev(n) for n in range(1, PANEL_H + 1)]  # LSB-first line addresses
        self.stride = PANEL_W // 8
        self.vcom = False
        self.last = None
        self.set_rotation(ROTATE)

    def set_rotation(self, deg):
        rot = 270 if deg == 270 else 90
        if getattr(self, "rot", None) == rot:
            return
        self.rot = rot
        self.transpose = _T.ROTATE_90 if self.rot == 90 else _T.ROTATE_270
        self.last = None  # next frame is sent whole

    def _send(self, buf):
        self.cs.on()
        self.spi.writebytes2(buf)
        self.cs.off()

    def _vbit(self):
        self.vcom = not self.vcom
        return 0x40 if self.vcom else 0x00

    def frame_bytes(self, img):
        """Every line of `img` as one write command (VCOM low): what the early splash replays."""
        data = img.transpose(self.transpose).tobytes()
        s = self.stride
        buf = bytearray([0x80])
        for y in range(PANEL_H):
            buf.append(self.addr[y])
            buf += data[y * s:(y + 1) * s]
            buf.append(0)
        buf.append(0)
        return bytes(buf)

    def vcom_only(self):
        """Nothing changed: just toggle VCOM (2 bytes)."""
        self._send(bytearray([self._vbit(), 0x00]))

    def show(self, img):
        """Full frame: send only changed panel lines, or just toggle VCOM."""
        vbit = self._vbit()
        data = img.transpose(self.transpose).tobytes()
        s = self.stride
        if self.last is None:
            lines = range(PANEL_H)
        else:
            last = self.last
            lines = [y for y in range(PANEL_H)
                     if data[y * s:(y + 1) * s] != last[y * s:(y + 1) * s]]
        self.last = bytearray(data)
        if lines:
            buf = bytearray([0x80 | vbit])
            for y in lines:
                buf.append(self.addr[y])
                buf += data[y * s:(y + 1) * s]
                buf.append(0)
            buf.append(0)
        else:
            buf = bytearray([vbit, 0x00])
        self._send(buf)

    def show_columns(self, img, ranges):
        """Fast path: send only the given portrait column ranges [(x0, x1), ...]."""
        if self.last is None:
            self.show(img)
            return
        s = self.stride
        buf = bytearray([0x80 | self._vbit()])
        for x0, x1 in ranges:
            part = img.crop((x0, 0, x1, H)).transpose(self.transpose).tobytes()
            base = (W - x1) if self.rot == 90 else x0
            for r in range(x1 - x0):
                row = base + r
                line = part[r * s:(r + 1) * s]
                self.last[row * s:(row + 1) * s] = line
                buf.append(self.addr[row])
                buf += line
                buf.append(0)
        buf.append(0)
        self._send(buf)

    def show_changed(self, img, ranges):
        """The bird's fast path: look only at the given portrait column ranges [(x0, x1), ...]
        and send just the panel lines in them that changed (each panel line is one portrait
        column). Nothing changed: just toggle VCOM."""
        if self.last is None:
            self.show(img)
            return
        s = self.stride
        vbit = self._vbit()
        buf = bytearray([0x80 | vbit])
        sent = 0
        for x0, x1 in ranges:
            part = img.crop((x0, 0, x1, H)).transpose(self.transpose).tobytes()
            base = (W - x1) if self.rot == 90 else x0
            for r in range(x1 - x0):
                row = base + r
                line = part[r * s:(r + 1) * s]
                if self.last[row * s:(row + 1) * s] != line:
                    self.last[row * s:(row + 1) * s] = line
                    buf.append(self.addr[row])
                    buf += line
                    buf.append(0)
                    sent += 1
        if sent:
            buf.append(0)
            self._send(buf)
        else:
            self._send(bytearray([vbit, 0x00]))

    def clear(self):
        self.last = None
        self.show(Image.new("1", (W, H), WHITE))


# ======================================================================
# Battery: MAX17048 fuel gauge if fitted, else the PowerBoost LBO pin
# ======================================================================
class ChargeDetector:
    """Notices the charger going in or out well before the gauge's own charge rate does (that's
    worked out from slow changes in its state-of-charge estimate, and lags by minutes).

    Plugging in lifts the cell voltage at once, and unplugging drops it. But the voltage also
    steps up when the player's own load eases off (music stopping, the screen sleeping, the
    boot rush settling), so a step is a guess until it's checked: charging keeps lifting the
    voltage at a steady pace for minutes, while a cell recovering from a load slows right down.
      - a big step (SHOW_V) shows at once, and is checked;
      - a smaller one (GUESS_V) shows only once the check confirms it;
      - nothing counts in the first couple of minutes after the UI starts (the boot settling);
      - the gauge's rate counts as charging only above RATE_ON: a resting cell drifts the
        estimate up by a percent or two an hour, which used to read as charging after boot.
    Every decision, and steps too small to count, go to the journal:
        journalctl -u currawong-ui | grep Charging"""
    SHOW_V = 0.12
    GUESS_V = 0.06
    NOTE_V = 0.03          # smaller than GUESS_V: only logged, so the thresholds can be tuned
    BIG_STEP_V = 0.18      # this big counts even in the quiet spell after a false alarm
    SETTLE_S = 120
    RATE_ON = 3.0          # %/h; real charging is 10-50 %/h
    RECENT_S = 8
    BEFORE_S = (20, 40)
    CHECK_AFTER_S = 150    # checked this long after the step: the climb 30-90 s after it against
    CHECK_FROM_S = 30      # 90-150 s. Charging keeps its pace (about 10 mV/min seen)
    RISE_MV_MIN = 4.0
    KEEPS_PACE = 0.7
    RATE_VETO_S = 240      # by then the gauge's rate has moved: if it clearly disagrees, it wins
    COOLDOWN_S = 300
    TRUST_S = 600
    KEEP_S = 200

    def __init__(self, log=None):
        self.samples = deque()   # (t, volts)
        self.event = None        # (t, charging, shown at once): the current guess
        self.checked = False
        self.started = None
        self.quiet_until = -1e9
        self.noted_at = -1e9
        self.log = log or (lambda msg: None)

    @staticmethod
    def _median(xs):
        xs = sorted(xs)
        return xs[len(xs) // 2] if xs else None

    def _rise(self, t0, t1):
        """Least-squares slope of the voltage over [t0, t1], in mV per minute (None: too few)."""
        pts = [(t, v) for t, v in self.samples if t0 <= t <= t1]
        if len(pts) < 8:
            return None
        mt = sum(t for t, _ in pts) / len(pts)
        mv = sum(v for _, v in pts) / len(pts)
        den = sum((t - mt) ** 2 for t, _ in pts)
        return sum((t - mt) * (v - mv) for t, v in pts) / den * 60_000 if den else None

    def add(self, now, volts):
        if self.started is None:
            self.started = now
        self.samples.append((now, volts))
        while self.samples and now - self.samples[0][0] > self.KEEP_S:
            self.samples.popleft()
        if self.event is not None and not self.checked and now - self.event[0] >= self.CHECK_AFTER_S:
            t, plugged, _ = self.event
            early = self._rise(t + self.CHECK_FROM_S, t + 90)
            rise = self._rise(t + 90, now)
            if plugged:  # still climbing, and at much the same pace
                ok = (rise is not None and rise >= self.RISE_MV_MIN
                      and (early is None or rise >= self.KEEPS_PACE * early))
            else:        # not climbing like a charger does
                ok = rise is not None and rise < self.RISE_MV_MIN
            what = "in" if plugged else "out"
            if ok:
                self.checked = True
                self.log(f"charger {what}: confirmed (then {rise:+.1f} mV/min)")
            else:
                self.event = None
                self.quiet_until = now + self.COOLDOWN_S
                self.log(f"charger {what}? no, a load change (then {rise if rise is not None else 0:+.1f} mV/min)")
        recent = [v for t, v in self.samples if now - t <= self.RECENT_S]
        before = [v for t, v in self.samples if self.BEFORE_S[0] <= now - t <= self.BEFORE_S[1]]
        if len(recent) < 3 or len(before) < 3 or now - self.started < self.SETTLE_S:
            return
        base = self._median(before)
        step = self._median(recent) - base
        if self.NOTE_V <= abs(step) < self.GUESS_V and now - self.noted_at > 60:
            self.noted_at = now
            self.log(f"voltage {step * 1000:+.0f} mV ({volts:.3f} V): too small to count")
        if now < self.quiet_until and abs(step) < self.BIG_STEP_V:
            return
        last = self.event[1] if self.event else None
        if step >= self.GUESS_V and min(recent) >= base + self.GUESS_V * 0.6 and last is not True:
            show = step >= self.SHOW_V
            self.event, self.checked = (now, True, show), False
            self.log(f"voltage up {step * 1000:+.0f} mV to {volts:.3f} V: charger in? "
                     + ("(showing it)" if show else "(checking first)"))
        elif step <= -self.GUESS_V and max(recent) <= base - self.GUESS_V * 0.6 and last is not False:
            show = step <= -self.SHOW_V
            self.event, self.checked = (now, False, show), False
            self.log(f"voltage down {step * 1000:+.0f} mV to {volts:.3f} V: charger out? "
                     + ("(showing it)" if show else "(checking first)"))

    def charging(self, now, rate):
        """The verdict: the current guess once it's shown (or confirmed), otherwise the rate."""
        by_rate = rate is not None and rate > self.RATE_ON
        if self.event is not None:
            t, plugged, shown = self.event
            agrees = (rate is not None and rate > self.RATE_ON) if plugged else (rate is None or rate < 0)
            vetoed = (rate is not None and now - t > self.RATE_VETO_S
                      and (rate < -2.0 if plugged else rate > 2.0 * self.RATE_ON))
            if vetoed:
                self.log(f"the gauge's rate ({rate:+.1f} %/h) says otherwise: going with it")
            if agrees or vetoed or now - t > self.TRUST_S:
                self.event = None
            elif shown or self.checked:
                return plugged
        return by_rate


CHARGE_PIN = None   # a GPIO wired to the PowerBoost's USB pin through a divider (e.g. 4, header pin 7):
                    # with it, charging is known for certain and at once (see the hardware notes)


class Battery:
    """The battery, from the MAX17048 fuel gauge (or, without it, the PowerBoost's LBO pin).

    Two protections, each with its own timer, both ending in power_off("BATTERY LOW"):
      - charge: the gauge's state of charge at or below BATT_SOC_LOW for LOW_BATT_SHUTDOWN_SECS.
        Paused only while the battery is *surely* charging (charge_confidence() == "yes": the
        wired charger pin, or the gauge's own rate clearly rising). A guess from the voltage
        alone doesn't pause it: if the charger isn't really there, the cell is still emptying.
      - voltage: the cell's voltage, as a median over BATT_VOLT_WINDOW_SECS (motor kicks last a
        fraction of a second and don't move the median), below the cutoff for
        BATT_VOLT_HOLD_SECS, or below BATT_CRITICAL_VOLTS for BATT_CRITICAL_HOLD_SECS. It clears
        only BATT_VOLT_HYST above the cutoff. Only the wired charger pin pauses this one.
    Readings that fail, or make no sense (0 V, 5 V, 300 %/h), are dropped. If the gauge stops
    answering, its last values stand for BATT_STALE_SECS; then the level reads as unknown (never
    "empty"), but a protection already counting down still finishes, since it can't be checked
    any more. A missing gauge is looked for again every REPROBE_EVERY seconds. The I2C load is
    as before: the voltage every 2 s, charge and rate every 15 s.
    """
    VOLT_EVERY = 2.0      # seconds between quick voltage reads
    FULL_EVERY = 15.0     # seconds between charge and rate reads
    REPROBE_EVERY = 30.0  # seconds between looks for a gauge that isn't answering

    def __init__(self, bus="auto", usb="auto", lbo="auto", log=None):
        self.log = log or (lambda m: print(f"Battery: {m}", flush=True))
        self.source = None      # "gauge", "lbo" or None
        self.pct = None
        self.low = False        # at or below BATT_SOC_LOW (or LBO): the icon's LOW, and the alerts
        self.charging = False   # the indicator's view: wired pin, else the voltage detector's guess
        self.rate = None        # %/hour from the gauge: negative while discharging
        self.volts = None
        self.low_since = None        # the charge protection's timer
        self.volt_low_since = None   # the voltage protection's timer
        self.volt_critical = False
        self.capacity_mah = BATTERY_MAH
        self.cutoff_volts = BATT_CUTOFF_VOLTS
        self.detector = ChargeDetector(log=lambda m: print(f"Charging: {m}", flush=True))
        self.gauge_ok = False
        self.fails = 0               # gauge reads failed in a row
        self.last_ok = None          # last time the gauge answered sensibly
        self.volts_ok_at = None      # last good voltage reading (a charge reading must have one beside it)
        self.full_at = None          # last good charge/rate reading
        self.rate_up_reads = 0       # charge/rate readings in a row with the rate clearly rising
        self.vhist = deque()         # (t, volts), for the median
        self.distrust_logged = False
        self._read_at = self._volts_at = -999.0
        self._reprobe_at = 0.0
        self._usb = self._pin(CHARGE_PIN, False) if usb == "auto" else usb
        self._lbo = self._pin(LBO_PIN, True) if lbo == "auto" else lbo   # with pull_up, 1 = LBO low
        if bus == "auto":
            try:
                try:
                    from smbus2 import SMBus
                except ImportError:
                    from smbus import SMBus
                bus = SMBus(1)
            except Exception:
                bus = None
        self._bus = bus
        if self._bus is not None:
            self._probe(0.0, quiet=True)
        if not self.gauge_ok and self._lbo is not None:
            self.source = "lbo"

    @staticmethod
    def _pin(pin, pull_up):
        if pin is None:
            return None
        try:
            from gpiozero import DigitalInputDevice
            return DigitalInputDevice(pin, pull_up=pull_up)
        except Exception:
            return None

    def configure(self, capacity_mah=None, cutoff_volts=None):
        """From the settings: the cell's capacity (for the drain estimate) and the voltage cutoff."""
        try:
            c = int(capacity_mah)
            self.capacity_mah = c if 100 <= c <= 20000 else BATTERY_MAH
        except (TypeError, ValueError):
            self.capacity_mah = BATTERY_MAH
        try:
            v = float(cutoff_volts)
            self.cutoff_volts = v if 3.0 <= v <= 3.6 else BATT_CUTOFF_VOLTS
        except (TypeError, ValueError):
            self.cutoff_volts = BATT_CUTOFF_VOLTS

    # -------------------------------------------------------------- reading the gauge
    def _word(self, reg):
        w = self._bus.read_word_data(0x36, reg)
        return ((w & 0xFF) << 8) | (w >> 8)  # the chip is big-endian

    def _probe(self, now, quiet=False):
        self._reprobe_at = now + self.REPROBE_EVERY
        try:
            self._word(0x04)
        except Exception:
            return False
        self.gauge_ok, self.source, self.fails, self.last_ok = True, "gauge", 0, now
        try:  # never hibernate: it samples every 250 ms instead of every 45 s (about 20 uA more)
            self._bus.write_word_data(0x36, 0x0A, 0x0000)
        except Exception:
            pass
        if not quiet:
            self.log("fuel gauge answering")
        return True

    def _fail(self, now, what):
        self.fails += 1
        if self.fails in (1, 10) or self.fails % 100 == 0:
            self.log(f"gauge read failed or made no sense ({what}), {self.fails} in a row")

    def _read_volts(self, now):
        try:
            v = self._word(0x02) * 78.125e-6
        except Exception:
            self._fail(now, "voltage")
            return
        if not BATT_VOLTS_SANE[0] <= v <= BATT_VOLTS_SANE[1]:
            self._fail(now, f"{v:.2f} V")
            return
        self.fails, self.last_ok, self.volts, self.volts_ok_at = 0, now, v, now
        self.vhist.append((now, v))
        while self.vhist and now - self.vhist[0][0] > 2 * BATT_VOLT_WINDOW_SECS:
            self.vhist.popleft()
        if self._usb is None:
            self.detector.add(now, v)
            self.charging = self.detector.charging(now, self.rate)

    def _read_full(self, now):
        if self.volts_ok_at is None or self.volts_ok_at < self._volts_at:
            # the latest voltage read failed or made no sense: a glitch that zeroes the bus zeroes
            # the voltage too, so a charge read beside it (0%, 0 %/h) isn't trusted
            self._fail(now, "charge, with no good voltage to check it against")
            return
        try:
            soc = self._word(0x04) / 256
            crate = self._word(0x16)
        except Exception:
            self._fail(now, "charge")
            return
        rate = (crate - 0x10000 if crate & 0x8000 else crate) * 0.208  # signed, 0.208 %/h per bit
        if soc > 110 or abs(rate) > 300:
            self._fail(now, f"{soc:.0f}%, {rate:+.0f} %/h")
            return
        self.fails, self.last_ok, self.full_at = 0, now, now
        self.pct = max(0, min(100, int(soc)))
        self.low = self.pct <= BATT_SOC_LOW
        self.rate = rate
        self.rate_up_reads = self.rate_up_reads + 1 if rate > ChargeDetector.RATE_ON else 0
        if self._usb is None:
            self.charging = self.detector.charging(now, self.rate)

    def _lost(self, now):
        """The gauge has stopped answering: unknown, never empty. Timers already running stay."""
        self.gauge_ok = False
        self._reprobe_at = now + self.REPROBE_EVERY
        self.pct = self.rate = self.volts = None
        self.vhist.clear()
        self.rate_up_reads = 0
        if self._usb is None:
            self.charging = False
        self.source = "lbo" if self._lbo is not None else "gauge"
        self.log(f"fuel gauge not answering for {BATT_STALE_SECS} s: level unknown"
                 + (" (a shutdown already counting down still happens)" if self.armed() else ""))

    def update(self, now):
        if self._usb is not None:  # wired: no guessing
            try:
                self.charging = bool(self._usb.value)
            except Exception:
                pass
        if self._bus is not None and not self.gauge_ok and now >= self._reprobe_at:
            self._probe(now)
        if self.gauge_ok:
            if now - self._volts_at >= self.VOLT_EVERY:
                self._volts_at = now
                self._read_volts(now)
            if now - self._read_at >= self.FULL_EVERY:
                self._read_at = now
                self._read_full(now)
            if now - (self.last_ok if self.last_ok is not None else now) > BATT_STALE_SECS:
                self._lost(now)
        if not self.gauge_ok and self._lbo is not None:
            try:
                self.low = bool(self._lbo.value)
            except Exception:
                pass
        self._protect(now)

    # -------------------------------------------------------------- what it all means
    def vmedian(self, now):
        """The cell voltage as a median over the last BATT_VOLT_WINDOW_SECS (None: too few)."""
        vs = sorted(v for t, v in self.vhist if now - t <= BATT_VOLT_WINDOW_SECS)
        return vs[len(vs) // 2] if len(vs) >= 3 else None

    def charge_confidence(self):
        """"yes" only when charging is sure: the wired pin, or the gauge's own rate clearly rising
        (two readings in a row), or the voltage detector's charger confirmed by its check with the
        rate not falling. "unsure" when it's only a guess; "no" otherwise."""
        if self._usb is not None:
            return "yes" if self.charging else "no"
        if self.gauge_ok:
            if self.rate_up_reads >= 2:
                return "yes"
            d = self.detector
            if d.event is not None and d.event[1] and d.checked and (self.rate is None or self.rate >= 0):
                return "yes"
        return "unsure" if self.charging else "no"

    def armed(self):
        return self.low_since is not None or self.volt_low_since is not None

    def _protect(self, now):
        # the charge protection: only on a fresh, believable reading (missing data leaves it alone)
        if self.gauge_ok and self.full_at is not None and now - self.full_at <= 2 * self.FULL_EVERY + 1:
            vm = self.vmedian(now)
            believable = vm is None or vm < BATT_SOC_TRUST_VOLTS
            if self.low and not believable and not self.distrust_logged:
                self.distrust_logged = True
                self.log(f"gauge says {self.pct}% but the cell is at {vm:.2f} V: not believed (still settling?)")
            sure = self.charge_confidence() == "yes"
            if self.low and believable and not sure:
                if self.low_since is None:
                    self.low_since = now
                    self.log(f"charge at {self.pct}%: switching off in {LOW_BATT_SHUTDOWN_SECS} s unless it "
                             f"charges ({self.charge_confidence()} charging)")
            elif self.low_since is not None:
                self.low_since = None
                self.log("charge shutdown cancelled: " + ("charging" if sure else f"back to {self.pct}%"))
        elif not self.gauge_ok and self._lbo is not None:      # no gauge: LBO, as before
            if self.low:
                self.low_since = self.low_since or now
            else:
                self.low_since = None
        # the voltage protection: only the wired pin pauses it
        vm = self.vmedian(now)
        if self._usb is not None and self.charging:
            if self.volt_low_since is not None:
                self.volt_low_since = None
                self.log("voltage shutdown cancelled: on USB power (charger pin)")
        elif vm is not None:
            if vm < self.cutoff_volts:
                self.volt_critical = vm < BATT_CRITICAL_VOLTS
                if self.volt_low_since is None:
                    self.volt_low_since = now
                    hold = BATT_CRITICAL_HOLD_SECS if self.volt_critical else BATT_VOLT_HOLD_SECS
                    self.log(f"cell at {vm:.2f} V (cutoff {self.cutoff_volts:.2f} V): switching off in {hold} s "
                             "unless it recovers")
            elif vm >= self.cutoff_volts + BATT_VOLT_HYST and self.volt_low_since is not None:
                self.volt_low_since = None
                self.volt_critical = False
                self.log(f"voltage shutdown cancelled: back to {vm:.2f} V")

    def shutdown_due(self, now):
        """None, or which protection has run out ("charge" or "voltage")."""
        if self.low_since is not None and now - self.low_since > LOW_BATT_SHUTDOWN_SECS:
            return "charge"
        if self.volt_low_since is not None:
            hold = BATT_CRITICAL_HOLD_SECS if self.volt_critical else BATT_VOLT_HOLD_SECS
            if now - self.volt_low_since > hold:
                return "voltage"
        return None

    def state(self):
        return (self.source, self.pct, self.low, self.charging)

    def drain_text(self):
        """An estimate of what the whole player draws from the cell: the gauge's %/hour times the
        capacity set in Settings. The MAX17048 doesn't measure current; this is worked out from
        how fast its state-of-charge estimate falls, averaged over minutes, so let it settle
        after a change before reading it. e.g. "~380 mA, 5.2 h"."""
        if self.source != "gauge" or self.rate is None:
            return "--"
        if self.charging:
            return "charging"
        if self.rate > -0.3:
            return "measuring"
        hours = f", {self.pct / -self.rate:.1f} h" if self.pct else ""
        return f"~{-self.rate * self.capacity_mah / 100:.0f} mA{hours}"

    def text(self):
        if self.source == "gauge" and self.pct is not None:
            return f"{self.pct}%"
        if self.source == "lbo":
            return "LOW" if self.low else "OK"
        return "N/A"


def battery_icon(d, x, y, batt):
    """22 x 11 battery at (x, y). Segments for the gauge, full/empty for LBO."""
    d.rectangle((x, y, x + 19, y + 10), outline=BLACK)
    d.rectangle((x + 20, y + 3, x + 21, y + 7), fill=BLACK)
    if batt.source == "gauge" and batt.pct is not None:
        segs = min(4, math.ceil(batt.pct / 25))
    elif batt.source == "lbo":
        segs = 0 if batt.low else 4
    else:
        d.text((x + 7, y), "?", font=F_TINY, fill=BLACK)
        return
    if getattr(batt, "charging", False):
        # a lightning bolt inside the outline instead of the level
        d.polygon([(x + 11, y + 1), (x + 6, y + 6), (x + 9, y + 6), (x + 8, y + 10), (x + 14, y + 4), (x + 11, y + 4)], fill=BLACK)
        return
    for i in range(segs):
        d.rectangle((x + 2 + i * 4, y + 2, x + 4 + i * 4, y + 8), fill=BLACK)
    if batt.low:
        d.text((x - 22, y), "LOW", font=F_TINY, fill=BLACK)


# ======================================================================
# MPD client (plain text protocol, no extra packages)
# ======================================================================
def mpd_quote(s):
    return '"' + str(s).replace("\\", "\\\\").replace('"', '\\"') + '"'


class MPDError(Exception):
    pass


class MPDClient:
    def __init__(self, host=MPD_HOST, port=MPD_PORT, timeout=3):
        self.host, self.port, self.timeout = host, port, timeout
        self.sock = None
        self.rfile = None
        self.lock = threading.RLock()

    def _connect(self):
        self.close()
        s = socket.create_connection((self.host, self.port), timeout=self.timeout)
        self.sock, self.rfile = s, s.makefile("rb")
        if not self.rfile.readline().startswith(b"OK MPD"):
            self.close()
            raise MPDError("not an MPD server")
        try:  # cover art in big pieces: MPD's default 8 KB meant hundreds of round trips per cover
            self.sock.sendall(b"binarylimit 524288\n")
            self._read_pairs()
        except MPDError:
            pass  # an older MPD: the small pieces still work

    def close(self):
        try:
            if self.sock:
                self.sock.close()
        except OSError:
            pass
        self.sock = self.rfile = None

    def _read_pairs(self):
        pairs = []
        while True:
            raw = self.rfile.readline()
            if not raw:
                raise ConnectionError("MPD closed the connection")
            line = raw.decode("utf-8", "replace").rstrip("\n")
            if line == "OK":
                return pairs
            if line.startswith("ACK"):
                raise MPDError(line)
            if line == "list_OK":
                continue
            k, _, v = line.partition(": ")
            pairs.append((k, v))

    def _run(self, payload):
        with self.lock:
            for attempt in (0, 1):
                try:
                    if self.sock is None:
                        self._connect()
                    self.sock.sendall(payload)
                    return self._read_pairs()
                except (OSError, ConnectionError):
                    self.close()
                    if attempt:
                        raise MPDError("MPD unreachable")

    def command(self, line):
        """Run one command, return [(key, value), ...]."""
        return self._run(line.encode("utf-8") + b"\n")

    def command_list(self, lines):
        body = "command_list_begin\n" + "".join(l + "\n" for l in lines) + "command_list_end\n"
        return self._run(body.encode("utf-8"))

    def as_dict(self, line):
        return dict(self.command(line))

    def values(self, line, key):
        return [v for k, v in self.command(line) if k == key]

    def records(self, line, first="file"):
        out, cur = [], None
        for k, v in self.command(line):
            if k == first:
                cur = {}
                out.append(cur)
            if cur is not None:
                cur[k] = v
        return out

    def _binary(self, cmd, uri):
        with self.lock:
            if self.sock is None:
                self._connect()
            buf, offset = bytearray(), 0
            while True:
                self.sock.sendall(f"{cmd} {mpd_quote(uri)} {offset}\n".encode("utf-8"))
                size, chunk = None, b""
                while True:
                    raw = self.rfile.readline()
                    if not raw:
                        raise ConnectionError("MPD closed the connection")
                    line = raw.decode("utf-8", "replace").rstrip("\n")
                    if line == "OK":
                        break
                    if line.startswith("ACK"):
                        raise MPDError(line)
                    k, _, v = line.partition(": ")
                    if k == "size":
                        size = int(v)
                    elif k == "binary":
                        chunk = self.rfile.read(int(v))
                        self.rfile.read(1)  # newline after the binary block
                if not chunk:
                    return bytes(buf) or None
                buf += chunk
                offset += len(chunk)
                if size is None or offset >= size:
                    return bytes(buf)

    def picture(self, uri):
        """Embedded cover (readpicture), else a cover file in the album folder (albumart).
        None means the song has no cover. A dropped or slow connection raises OSError instead,
        so the caller can try again rather than decide there's no cover."""
        for cmd in ("readpicture", "albumart"):
            try:
                data = self._binary(cmd, uri)
                if data:
                    return data
            except MPDError:
                continue
            except (OSError, ConnectionError) as e:
                self.close()
                raise OSError(f"cover fetch interrupted: {e}") from e
        return None


# ======================================================================
# Player: both sources, polled in the background
# ======================================================================
class Snap:
    reachable = False        # at least one player is reachable
    source = None            # "spotify", "local" or None
    has_track = playing = paused = False
    uri = title = artists = album = ""
    pos = dur = 0
    fmt = ""
    cover = None
    shuffle = repeat = False


def local_format(audio, path):
    """MPD 'audio' (e.g. 48000:24:2) + file extension -> 'FLAC 48k/24'."""
    ext = os.path.splitext(path)[1].lstrip(".").upper() or "FILE"
    try:
        rate, bits, _ = audio.split(":")
        r = int(rate) / 1000
        rate_s = f"{r:g}k"
        return f"{ext} {rate_s}/{bits}" if bits.isdigit() else f"{ext} {rate_s}"
    except Exception:
        return ext


class LibrespotAPI:
    """Keep-alive HTTP to go-librespot, one connection per thread. Much cheaper on a Zero W than
    opening a new urllib connection (and resolving "localhost") every second."""

    def __init__(self, host=API_HOST, port=API_PORT):
        self.host, self.port = host, port
        self.local = threading.local()

    def request(self, method, path, body=None, timeout=3):
        """Returns (status, body bytes). Raises OSError when go-librespot can't be reached."""
        data = json.dumps(body).encode() if body is not None else None
        headers = {"Content-Type": "application/json"} if data is not None else {}
        for attempt in (0, 1):
            conn = getattr(self.local, "conn", None)
            if conn is None:
                conn = http.client.HTTPConnection(self.host, self.port, timeout=timeout)
                self.local.conn = conn
            try:
                conn.request(method, path, body=data, headers=headers)
                resp = conn.getresponse()
                return resp.status, resp.read()
            except (OSError, http.client.HTTPException):
                conn.close()
                self.local.conn = None
                if attempt:
                    raise OSError("go-librespot unreachable")
        return 0, b""


class Player:
    def __init__(self):
        self.lock = threading.Lock()
        self.interval = 1.0
        self.kick = threading.Event()
        self.sp, self.sp_at = None, 0.0        # go-librespot status
        self.mp, self.mp_at = None, 0.0        # MPD status + current song
        self.active = None
        self.hold = None   # a source to show while it's being resumed (Resume sets and clears it)
        self.was_sp_playing = self.was_mp_playing = False
        self.mpd_poll = MPDClient()
        self.mpd = MPDClient()                 # commands from the UI
        self.mpd_art = MPDClient()             # cover art fetches
        self.covers = {}
        self.cover_pending = set()
        self.cover_retry = {}   # key -> (failures so far, when to try again): fetches that failed
                                # (a timeout, a dropped connection), as opposed to "no cover"
        self.seek_override = None
        self.seek_target = None
        self.seek_event = threading.Event()
        self.api = LibrespotAPI()
        threading.Thread(target=self._poll_loop, name="poll", daemon=True).start()
        threading.Thread(target=self._seek_loop, name="seek", daemon=True).start()

    # --- polling --------------------------------------------------
    def _poll_spotify(self):
        try:
            status, body = self.api.request("GET", "/status", timeout=2)
        except OSError:
            return None
        if status == 200 and body:
            try:
                return json.loads(body)
            except ValueError:
                return {}
        return {}

    def _poll_mpd(self):
        try:
            return dict(self.mpd_poll.command_list(["status", "currentsong"]))
        except MPDError:
            return None

    def _poll_loop(self):
        while True:
            sp, mp = self._poll_spotify(), self._poll_mpd()
            now = time.monotonic()
            sp_playing = bool(sp and sp.get("track") and not sp.get("stopped") and not sp.get("paused"))
            mp_playing = bool(mp and mp.get("state") == "play")

            # Only one source plays at a time: the one that started most recently wins
            if sp_playing and mp_playing:
                if not self.was_sp_playing:
                    self._mpd_quiet("pause 1")
                    mp_playing = False
                else:
                    self._spotify_post("/player/pause")
                    sp_playing = False
            self.was_sp_playing, self.was_mp_playing = sp_playing, mp_playing

            with self.lock:
                self.sp, self.sp_at = sp, now
                self.mp, self.mp_at = mp, now
                if mp_playing:
                    self.active = "local"
                elif sp_playing:
                    self.active = "spotify"
                elif self.active == "local" and not (mp and mp.get("file")):
                    self.active = "spotify" if sp and sp.get("track") else None
                elif self.active == "spotify" and not (sp and sp.get("track")):
                    self.active = "local" if mp and mp.get("file") else None
                elif self.active is None:
                    if mp and mp.get("file"):
                        self.active = "local"
                    elif sp and sp.get("track"):
                        self.active = "spotify"
                if self.hold and not (mp_playing or sp_playing):
                    self.active = self.hold  # being resumed: not MPD's leftover queue meanwhile
            self._want_cover()
            self.kick.wait(self.interval)
            self.kick.clear()

    # --- covers ---------------------------------------------------
    def _want_cover(self):
        with self.lock:
            if self.active == "spotify" and self.sp:
                key = ((self.sp.get("track") or {}).get("album_cover_url"))
                job = ("url", key)
            elif self.active == "local" and self.mp:
                key = self.mp.get("file")
                job = ("mpd", key)
            else:
                return
            if not key or key in self.covers or key in self.cover_pending:
                return
            retry = self.cover_retry.get(key)
            if retry and time.monotonic() < retry[1]:
                return
            self.cover_pending.add(key)
        threading.Thread(target=self._fetch_cover, args=job, name="cover", daemon=True).start()

    COVER_RETRY_SECS = (3, 10, 30)   # after a failed fetch; then it's taken as having none

    def _fetch_cover(self, kind, key):
        covers, failed = None, False
        try:
            if kind == "url":
                with urllib.request.urlopen(key, timeout=8) as r:
                    raw = r.read()
            else:
                raw = self.mpd_art.picture(key)
            if raw:
                covers = make_covers(raw)
        except urllib.error.HTTPError as e:
            failed = e.code >= 500 or e.code == 429  # the server's trouble: try again; 404 etc.: none
        except OSError:
            failed = True        # timeout, no network, MPD busy: try again
        except Exception:        # noqa: BLE001 - an image PIL can't read: there's no cover to show
            covers = None
        with self.lock:
            self.cover_pending.discard(key)
            if failed:
                n = self.cover_retry.get(key, (0, 0))[0]
                if n < len(self.COVER_RETRY_SECS):
                    self.cover_retry[key] = (n + 1, time.monotonic() + self.COVER_RETRY_SECS[n])
                    return
            self.cover_retry.pop(key, None)
            while len(self.covers) > 8:
                self.covers.pop(next(iter(self.covers)))
            self.covers[key] = covers

    # --- commands -------------------------------------------------
    def _spotify_post_now(self, path, body=None):
        try:
            self.api.request("POST", path, body or {})
        except OSError:
            pass
        self.kick.set()

    def _spotify_post(self, path, body=None):
        threading.Thread(target=self._spotify_post_now, args=(path, body), name="post", daemon=True).start()

    def _mpd_quiet(self, *lines):
        try:
            if len(lines) == 1:
                self.mpd.command(lines[0])
            else:
                self.mpd.command_list(list(lines))
        except MPDError:
            pass
        self.kick.set()

    def play_pause(self, snap):
        if snap.source == "local":
            self._mpd_quiet("pause 1" if snap.playing else "play")
        elif snap.source == "spotify" and snap.has_track:
            self._spotify_post("/player/resume" if snap.paused else "/player/pause")

    def next(self, snap):
        if snap.source == "local":
            self._mpd_quiet("next")
        elif snap.source == "spotify":
            self._spotify_post("/player/next")

    def prev(self, snap):
        if snap.source == "local":
            self._mpd_quiet("previous")
        elif snap.source == "spotify":
            self._spotify_post("/player/prev")

    def seek_by(self, snap, delta_ms):
        """Dial scrubbing: the screen shows the new position at once, and one seek is sent when
        the dial pauses (so a fast spin is one seek, not dozens)."""
        if not snap.has_track or not snap.dur:
            return
        now = time.monotonic()
        base = (self.seek_override[0] if self.seek_override and now < self.seek_override[1]
                else snap.pos)
        target = max(0, min(snap.dur - 1000, base + delta_ms))
        self.seek_override = (target, now + 1.5)
        self.seek_target = (snap.source, int(target))
        self.seek_event.set()

    def seek_to(self, snap, pos_ms):
        """Immediate seek, for auto-scrub."""
        pos_ms = int(max(0, min(snap.dur - 1000, pos_ms) if snap.dur else pos_ms))
        self.seek_override = (pos_ms, time.monotonic() + 1.0)
        if snap.source == "local":
            self._mpd_quiet(f"seekcur {pos_ms / 1000:.1f}")
        elif snap.source == "spotify":
            self._spotify_post("/player/seek", {"position": pos_ms})

    def _seek_loop(self):
        """Waits for the dial to pause: 0.12 s for local files, 0.35 s for Spotify (which rebuffers)."""
        while True:
            self.seek_event.wait()
            self.seek_event.clear()
            while self.seek_event.wait(0.12 if self.seek_target[0] == "local" else 0.35):
                self.seek_event.clear()
            source, pos = self.seek_target
            if source == "local":
                self._mpd_quiet(f"seekcur {pos / 1000:.1f}")
            else:
                self._spotify_post_now("/player/seek", {"position": pos})

    def play_files(self, files, index=0, shuffle=False):
        """Replace the MPD queue and start playing (pauses Spotify first)."""
        if self.was_sp_playing:
            self._spotify_post_now("/player/pause")
        lines = ["clear", f"random {1 if shuffle else 0}"]
        lines += [f"add {mpd_quote(f)}" for f in files]
        lines.append(f"play {index}")
        self._mpd_quiet(*lines)

    # --- library --------------------------------------------------
    def lib_artists(self):
        names = [v for v in self.mpd.values("list albumartist", "AlbumArtist") if v]
        if not names:
            names = [v for v in self.mpd.values("list artist", "Artist") if v]
        return sorted(set(names), key=str.casefold)

    def lib_albums(self, artist=None):
        if artist is None:
            names = self.mpd.values("list album", "Album")
        else:
            names = self.mpd.values(f"list album albumartist {mpd_quote(artist)}", "Album")
            if not names:
                names = self.mpd.values(f"list album artist {mpd_quote(artist)}", "Album")
        return sorted({v for v in names if v}, key=str.casefold)

    def lib_tracks(self, artist=None, album=None):
        cmd = "find"
        if album is not None:
            cmd += f" album {mpd_quote(album)}"
        if artist is not None:
            cmd += f" albumartist {mpd_quote(artist)}"
        recs = self.mpd.records(cmd)
        if not recs and artist is not None:
            recs = self.mpd.records(cmd.replace(" albumartist ", " artist "))

        def num(v):
            try:
                return int(str(v).split("/")[0])
            except ValueError:
                return 0
        return sorted(recs, key=lambda r: (num(r.get("Disc", 0)), num(r.get("Track", 0)), r.get("file", "")))

    def lib_playlists(self):
        return sorted((v for v in self.mpd.values("listplaylists", "playlist") if v), key=str.casefold)

    def play_playlist(self, name, shuffle=False):
        if self.was_sp_playing:
            self._spotify_post_now("/player/pause")
        self._mpd_quiet("clear", f"random {1 if shuffle else 0}", f"load {mpd_quote(name)}", "play")

    def save_queue(self, name):
        try:
            self.mpd.command(f"save {mpd_quote(name)}")
            return True, ""
        except MPDError as e:
            return False, "A playlist with that name exists." if "exist" in str(e).lower() else str(e)

    def playlist_add(self, name, uri):
        try:
            self.mpd.command(f"playlistadd {mpd_quote(name)} {mpd_quote(uri)}")
            return True
        except MPDError:
            return False

    def playlist_delete(self, name):
        self._mpd_quiet(f"rm {mpd_quote(name)}")

    def playlist_songs(self, name):
        """A stored playlist's songs as records (file, Title, duration...), in order."""
        return self.mpd.records(f"listplaylistinfo {mpd_quote(name)}")

    def playlist_files(self, name):
        """A stored playlist's files; [] if there's no such playlist yet."""
        try:
            return self.mpd.values(f"listplaylist {mpd_quote(name)}", "file")
        except MPDError as e:
            if "no such playlist" in str(e).lower():
                return []
            raise

    def playlist_add_many(self, name, uris):
        """Add songs to a playlist (making it if it's new), skipping ones already in it.
        Returns (added, already there), or (None, 0) if MPD refused."""
        try:
            have = set(self.playlist_files(name))
            new = []
            for u in uris:
                if u not in have:
                    have.add(u)
                    new.append(u)
            if new:
                self.mpd.command_list([f"playlistadd {mpd_quote(name)} {mpd_quote(u)}" for u in new])
            return len(new), len(uris) - len(new)
        except MPDError:
            return None, 0

    def playlist_create(self, name):
        """A new, empty playlist; Up Next and what's playing are left alone. MPD has no command
        for an empty one, so a song is added (which makes the playlist) and taken straight out
        again, in one go. Refuses a name that's taken, so it can't empty an existing playlist."""
        try:
            if name in self.lib_playlists():
                return False, "A playlist with that name exists."
            one = self.mpd.values(f"find {mpd_quote(MPD_ANY_SONG)} window 0:1", "file")
            if not one:
                return False, "Add some music first."
            q = mpd_quote(name)
            self.mpd.command_list([f"playlistadd {q} {mpd_quote(one[0])}", f"playlistdelete {q} 0"])
            return True, ""
        except MPDError as e:
            return False, str(e)

    def playlist_remove(self, name, pos):
        self._mpd_quiet(f"playlistdelete {mpd_quote(name)} {int(pos)}")

    def playlist_move(self, name, src, dst):
        self._mpd_quiet(f"playlistmove {mpd_quote(name)} {int(src)} {int(dst)}")

    def playlist_rename(self, old, new):
        try:
            self.mpd.command(f"rename {mpd_quote(old)} {mpd_quote(new)}")
            return True, ""
        except MPDError as e:
            return False, "A playlist with that name exists." if "exist" in str(e).lower() else str(e)

    def play_playlist_from(self, name, pos):
        if self.was_sp_playing:
            self._spotify_post_now("/player/pause")
        self._mpd_quiet("clear", "random 0", f"load {mpd_quote(name)}", f"play {int(pos)}")

    def playlist_to_queue(self, name):
        """The playlist's songs onto the end of Up Next (nothing else changes)."""
        self._mpd_quiet(f"load {mpd_quote(name)}")

    def _current_pos(self):
        cur = self.mpd.as_dict("status").get("song")
        return int(cur) if cur and cur.isdigit() else -1

    def queue_add(self, uris):
        self._mpd_quiet(*[f"add {mpd_quote(u)}" for u in uris])

    def queue_add_next(self, uris):
        """Songs straight after the one playing (or at the end, if nothing is)."""
        try:
            cur = self._current_pos()
        except MPDError:
            return
        if cur < 0:
            self.queue_add(uris)
        else:
            self._mpd_quiet(*[f"addid {mpd_quote(u)} {cur + 1 + i}" for i, u in enumerate(uris)])

    def queue_remove(self, pos):
        self._mpd_quiet(f"delete {int(pos)}")

    def queue_move_next(self, pos):
        """Move a song in Up Next to straight after the one playing."""
        try:
            cur = self._current_pos()
        except MPDError:
            return
        if cur < 0 or pos == cur:
            return
        self._mpd_quiet(f"move {int(pos)} {cur + 1 if pos > cur else cur}")

    def queue(self):
        """MPD's queue as records, plus the position of the current song."""
        recs = self.mpd.records("playlistinfo")
        cur = self.mpd.as_dict("status").get("song")
        return recs, int(cur) if cur and cur.isdigit() else -1

    def play_pos(self, pos):
        if self.was_sp_playing:
            self._spotify_post_now("/player/pause")
        self._mpd_quiet(f"play {pos}")

    def toggle_shuffle(self, snap):
        if snap.source == "local":
            self._mpd_quiet(f"random {0 if snap.shuffle else 1}")
        elif snap.source == "spotify":
            # go-librespot API (see its api-spec.yml); ignored quietly if the endpoint differs
            self._spotify_post("/player/shuffle_context", {"shuffle_context": not snap.shuffle})

    def toggle_repeat(self, snap):
        if snap.source == "local":
            self._mpd_quiet(f"repeat {0 if snap.repeat else 1}")
        elif snap.source == "spotify":
            self._spotify_post("/player/repeat_context", {"repeat_context": not snap.repeat})

    def spotify_play(self, uri):
        """Start a Spotify context (playlist, album) on go-librespot. Returns True on success."""
        if self.was_mp_playing:
            self._mpd_quiet("pause 1")
        try:
            status, _ = self.api.request("POST", "/player/play", {"uri": uri}, timeout=8)
            ok = status == 200
        except OSError:
            ok = False
        self.kick.set()
        return ok

    def shuffle_all(self):
        if self.was_sp_playing:
            self._spotify_post_now("/player/pause")
        self._mpd_quiet("clear", 'add "/"', "random 1", "play")

    def rescan(self):
        self._mpd_quiet("update")

    # --- snapshot -------------------------------------------------
    def snapshot(self):
        now = time.monotonic()
        with self.lock:
            sp, sp_at, mp, mp_at = self.sp, self.sp_at, self.mp, self.mp_at
            active = self.active
            covers = self.covers
            s = Snap()
            s.reachable = sp is not None or mp is not None
            s.source = active
            if active == "spotify" and sp and sp.get("track") and not sp.get("stopped"):
                t = sp["track"]
                s.cover = covers.get(t.get("album_cover_url"))
            elif active == "local" and mp and mp.get("file"):
                s.cover = covers.get(mp.get("file"))
            else:
                return s

        if active == "spotify":
            t = sp["track"]
            s.has_track = True
            s.uri = t.get("uri") or t.get("name", "")
            s.title = t.get("name") or ""
            s.artists = ", ".join(t.get("artist_names") or [])
            s.album = t.get("album_name") or ""
            s.paused = bool(sp.get("paused"))
            s.playing = not s.paused
            s.dur = t.get("duration") or 0
            pos = t.get("position", sp.get("position"))
            if pos is None:
                pos = 0
            elif s.playing and not sp.get("buffering"):
                pos += (now - sp_at) * 1000
            if self.seek_override and now < self.seek_override[1]:
                pos = self.seek_override[0]
            s.fmt = SPOTIFY_FORMAT
            s.shuffle = bool(sp.get("shuffle_context"))
            s.repeat = bool(sp.get("repeat_context") or sp.get("repeat_track"))
        else:
            s.has_track = True
            s.uri = mp.get("file", "")
            s.title = mp.get("Title") or os.path.splitext(os.path.basename(s.uri))[0]
            s.artists = mp.get("Artist") or mp.get("AlbumArtist") or ""
            s.album = mp.get("Album") or ""
            s.playing = mp.get("state") == "play"
            s.paused = not s.playing
            try:
                s.dur = float(mp.get("duration") or mp.get("Time") or 0) * 1000
                pos = float(mp.get("elapsed") or 0) * 1000
            except ValueError:
                s.dur, pos = 0, 0
            if s.playing:
                pos += (now - mp_at) * 1000
            if self.seek_override and now < self.seek_override[1]:
                pos = self.seek_override[0]
            s.fmt = local_format(mp.get("audio", ""), s.uri)
            s.shuffle = mp.get("random") == "1"
            s.repeat = mp.get("repeat") == "1"
        s.pos = max(0, min(pos, s.dur) if s.dur else pos)
        return s


# ======================================================================
# Resume on power up
# ======================================================================
RESUME_FILE = os.path.expanduser("~/.config/currawong/resume.json")
RESUME_SAVE_SECS = 10     # while playing, the place is saved this often: a power cut loses at most this
RESUME_WINDOW_SECS = 300  # how long after a start to keep trying (Spotify waits for Wi-Fi and its login)
RESUME_RETRY_SECS = 2


class Resume:
    """Remembers what was playing and where, and puts it back after a restart: the same source,
    track and second, and for Spotify the same playlist or album, ready to play or playing
    (Settings > On power up). MPD's own state file is only written a while after a change, so
    sliding the switch off could lose the place; this is written every few seconds while
    playing, and straight away on any change or power-off."""

    def __init__(self, player, settings, path=None):
        self.player, self.settings = player, settings
        self.path = path or RESUME_FILE
        self.saved = self._load()
        self.pending = self.saved if (self.saved and settings.get("resume", "ready") != "off") else None
        self.started = time.monotonic()
        self.next_try = 0.0
        self.last_save = -1e9
        self.last_key = None
        if self.pending:
            self.player.hold = self.pending["source"]
            STATUS["resuming"] = self.pending.get("title") or "where you left off"

    def _load(self):
        try:
            with open(self.path) as f:
                data = json.load(f)
            if data.get("source") in ("local", "spotify") and data.get("uri"):
                return data
        except (OSError, ValueError, AttributeError):
            pass
        return None

    def _sp(self):
        sp = getattr(self.player, "sp", None)
        return sp if isinstance(sp, dict) else None

    def point(self, snap):
        """What to remember now, or None when there's nothing worth remembering."""
        if not snap.has_track or snap.source not in ("local", "spotify") or not snap.uri:
            return None
        p = {"source": snap.source, "uri": snap.uri, "pos": int(snap.pos), "title": snap.title,
             "saved": int(time.time())}
        sp = self._sp() or {}
        if snap.source == "spotify" and sp.get("context_uri"):
            p["context"] = sp["context_uri"]
        return p

    def save(self, snap, now=None):
        p = self.point(snap)
        if p is None:
            return
        try:
            os.makedirs(os.path.dirname(self.path), exist_ok=True)
            with open(self.path + ".tmp", "w") as f:
                json.dump(p, f)
            os.replace(self.path + ".tmp", self.path)
        except OSError:
            return
        self.last_save = time.monotonic() if now is None else now

    def _finish(self, source=None):
        self.pending = None
        self.player.hold = None
        STATUS.pop("resuming", None)
        if source:
            with self.player.lock:
                self.player.active = source

    def tick(self, now, snap):
        """Every step: put things back once after a start, then keep the place saved."""
        if self.pending is not None:
            if snap.playing or now - self.started > RESUME_WINDOW_SECS:
                self._finish()  # something's already playing (by hand, or from a phone), or too late
            elif now >= self.next_try:
                self.next_try = now + RESUME_RETRY_SECS
                r = self.pending
                play = self.settings.get("resume", "ready") == "play"
                done = self._local(r, play) if r["source"] == "local" else self._spotify(r, play)
                if done is None:
                    self._finish()             # nothing left to put back
                elif done:
                    self._finish(r["source"])  # restored: show it
            return
        if not snap.has_track or snap.source not in ("local", "spotify"):
            return
        key = (snap.source, snap.uri, snap.playing)
        if key != self.last_key or (snap.playing and now - self.last_save >= RESUME_SAVE_SECS):
            self.last_key = key
            self.save(snap, now)

    def _local(self, r, play):
        """True: put back. False: not yet, try again. None: nothing to put back."""
        mp = getattr(self.player, "mp", None)
        if not isinstance(mp, dict):
            return False  # MPD isn't up yet (it starts after the first screen)
        secs = f"{max(0, r.get('pos', 0)) / 1000:.1f}"
        mpd = self.player.mpd
        try:
            if mp.get("file") == r["uri"] and mp.get("state") == "pause":
                cmds = [f"seekcur {secs}"]  # MPD put the song back itself: just the second
            else:
                found = mpd.values(f"playlistfind file {mpd_quote(r['uri'])}", "Pos")
                if found:
                    cmds = [f"seek {found[0]} {secs}", "pause 1"]
                else:
                    added = mpd.values(f"addid {mpd_quote(r['uri'])}", "Id")
                    if not added:
                        return None  # not in the library any more: nothing to put back
                    cmds = [f"seekid {added[0]} {secs}", "pause 1"]
            if play:
                cmds.append("pause 0")
            mpd.command_list(cmds)
        except MPDError as e:
            if "No such" in str(e) or "Not found" in str(e):
                return None  # gone from the library: give up
            return False     # MPD busy or restarting: try again
        self.player.kick.set()
        return True

    def _spotify(self, r, play):
        sp = self._sp()
        if not sp or not sp.get("username"):
            return False  # not signed in yet: Wi-Fi, or go-librespot hasn't logged back in
        body = {"uri": r.get("context") or r["uri"], "paused": not play, "position": max(0, r.get("pos", 0))}
        if r.get("context") and r["context"] != r["uri"]:
            body["skip_to_uri"] = r["uri"]
        try:
            status, _ = self.player.api.request("POST", "/player/play", body, timeout=10)
        except OSError:
            return False
        if status == 200:
            self.player.kick.set()
            return True
        if r.get("context"):  # some lists can't be restarted: the track on its own, next try
            self.pending = {k: v for k, v in r.items() if k != "context"}
        return False


# ======================================================================
# Audio analyser: FFT spectra, BS.1770 loudness, peaks (from MPD's FIFO)
# ======================================================================
F_LO, F_HI = 50, 10000
STRIP_BINS = 40           # Now Playing strip resolution (1 px per bin)
SPEC_ROWS = 88            # Scope spectrogram rows
HOP = RATE // ANALYSIS_FPS


def log_bands(freqs, n):
    """Index ranges (lo, hi) into the FFT for n log-spaced bands from F_LO to F_HI."""
    edges = F_LO * (F_HI / F_LO) ** (np.arange(n + 1) / n)
    last = len(freqs) - 1
    lo = np.minimum(np.searchsorted(freqs, edges[:-1]), last)
    hi = np.minimum(np.maximum(lo + 1, np.searchsorted(freqs, edges[1:])), last + 1)
    return lo, hi


def k_weight_power(freqs):
    """|H(f)|^2 of the BS.1770 K-weighting filter (48 kHz coefficients)."""
    w = 2 * np.pi * np.minimum(freqs, 23999) / 48000
    z1 = np.exp(-1j * w)
    z2 = z1 * z1

    def biquad(b, a):
        return (b[0] + b[1] * z1 + b[2] * z2) / (a[0] + a[1] * z1 + a[2] * z2)

    h1 = biquad((1.53512485958697, -2.69169618940638, 1.19839281085285),
                (1.0, -1.69065929318241, 0.73248077421585))
    h2 = biquad((1.0, -2.0, 1.0), (1.0, -1.99004745483398, 0.99007225036621))
    return np.abs(h1 * h2) ** 2


class Frame:
    __slots__ = ("spec", "bins", "mom", "short", "peak", "level")


class FifoSource:
    """MPD's old fifo output (22050:16:2): only a fallback now, when the loopback isn't set up.
    Opened without blocking (a plain open() waits until MPD starts writing). Reads wait at most
    `timeout` and check `cancelled` every TAP_POLL, so the analyser can always stop; a partial
    block is kept for the next call, so samples never come out misaligned."""
    eof_is_idle = True   # a fifo with no writer reads as EOF: that only means "nothing yet"

    def __init__(self, path):
        self.fd = os.open(path, os.O_RDONLY | os.O_NONBLOCK)
        self.raw = self.out = None
        self.have = 0

    def fileno(self):
        return self.fd

    def close(self):
        try:
            os.close(self.fd)
        except OSError:
            pass

    def read_block(self, n, timeout=None, cancelled=None):
        """n stereo frames as float32 (n, 2), scaled to +-1. The array is reused by the next call.
        None if cancelled; TimeoutError if a whole block didn't arrive in time."""
        need = n * 4
        if self.raw is None or len(self.raw) != need:
            self.raw, self.out, self.have = bytearray(need), np.empty((n, 2), np.float32), 0
        view = memoryview(self.raw)
        deadline = None if timeout is None else time.monotonic() + timeout
        while self.have < need:
            if cancelled is not None and cancelled():
                return None
            wait = TAP_POLL
            if deadline is not None:
                wait = min(wait, deadline - time.monotonic())
                if wait <= 0:
                    raise TimeoutError
            if not select.select([self.fd], [], [], wait)[0]:
                continue
            try:
                got = os.readv(self.fd, [view[self.have:need]])
            except BlockingIOError:
                continue
            if got == 0:
                if not self.eof_is_idle:
                    raise EOFError
                time.sleep(min(0.05, wait))
                continue
            self.have += got
        self.have = 0
        # int16 -> float32 is exact, and x * 2**-15 == x / 32768 exactly: the same numbers as before
        np.multiply(np.frombuffer(self.raw, "<i2").reshape(n, 2), np.float32(1 / 32768), out=self.out)
        return self.out


class LoopbackSource(FifoSource):
    """Records MPD's Visualiser output from the far end of the ALSA loopback card (snd-aloop).
    The loopback is clocked like a real sound card, so MPD keeps it a second ahead just like the
    DAC. MPD's fifo output is paced to real time instead, and MPD never queues more than 64
    chunks past its slowest output: at 48 kHz/24-bit that held the DAC to 0.67 s of buffer and
    it ran out a few seconds into a track ("Decoder is too slow; playing silence").

    arecord's pipe is read without blocking; close() always ends and reaps arecord (terminate,
    then kill), so none is left behind, whatever went wrong."""
    eof_is_idle = False  # arecord's pipe closing means arecord has gone

    def __init__(self, device=LOOPBACK_CAPTURE):
        self.proc = subprocess.Popen(
            ["arecord", "-q", "-D", device, "-t", "raw", "-f", "S16_LE", "-r", str(RATE), "-c", "2",
             "--buffer-time=200000", "-"],
            stdin=subprocess.DEVNULL, stdout=subprocess.PIPE, stderr=subprocess.DEVNULL, bufsize=0)
        self.fd = self.proc.stdout.fileno()
        os.set_blocking(self.fd, False)
        self.raw = self.out = None
        self.have = 0

    def close(self):
        p = self.proc
        if p.poll() is None:
            try:
                p.terminate()
                p.wait(timeout=1.0)
            except subprocess.TimeoutExpired:
                p.kill()
                try:
                    p.wait(timeout=1.0)
                except subprocess.TimeoutExpired:
                    pass
            except OSError:
                pass
        try:
            p.stdout.close()
        except OSError:
            pass


def open_audio_tap():
    """The loopback when it's set up (currawong_setup.sh loads snd-aloop), otherwise the old fifo."""
    if os.path.exists("/proc/asound/Loopback"):
        return LoopbackSource()
    return FifoSource(MPD_FIFO)


class SynthSource:
    """Simulated music, used only by --preview."""

    def __init__(self):
        self.n = 0
        self.rng = np.random.default_rng(1)

    def read_block(self, n):
        t = (self.n + np.arange(n)) / RATE
        self.n += n
        beat = 0.5
        ph = t % beat
        kick = np.sin(2 * np.pi * (45 + 90 * np.exp(-ph * 25)) * ph) * np.exp(-ph * 9)
        bar = (t // (beat * 4)).astype(int) % 4
        bass_f = np.array([55.0, 65.4, 49.0, 73.4])[bar]
        bass = np.sin(2 * np.pi * bass_f * t) * (0.6 + 0.4 * np.exp(-((t + beat / 2) % beat) * 6))
        noise = self.rng.standard_normal(n)
        hat = np.diff(noise, prepend=0.0) * np.exp(-((t + beat / 2) % beat) * 45)
        swell = 0.5 + 0.5 * np.sin(2 * np.pi * t / 8)
        pad = sum(np.sin(2 * np.pi * f * t) for f in (220.0, 277.2, 329.6, 440.0)) * 0.25 * swell
        lead = np.sin(2 * np.pi * (880 + 220 * np.sin(2 * np.pi * t / 3)) * t) * 0.08 * (1 - swell)
        spec = np.fft.rfft(self.rng.standard_normal(n))
        spec /= np.sqrt(np.maximum(np.arange(spec.size), 1))       # 1/f: pink noise
        pink = np.fft.irfft(spec, n)
        pink *= 0.07 / (np.sqrt(np.mean(pink ** 2)) + 1e-9) * (0.6 + 0.4 * swell)
        left = 0.42 * kick + 0.22 * bass + 0.06 * hat + 0.12 * pad + lead + pink
        right = 0.42 * kick + 0.22 * bass + 0.09 * hat + 0.10 * pad + 0.6 * lead + pink
        return np.stack([left, right], axis=1).astype(np.float32) * 1.6


class VisualiserOutput:
    """MPD's "Visualiser" output (its copy of the music for the analyser, played into the ALSA
    loopback) switched on only while the analyser is recording it. The rest of the time (FAST
    visuals, Glance, Sleep, menus, Spotify) MPD needn't resample and write a second copy of every
    local track. Only that output is ever touched: the DAC's carries on as it was.

    Called from the analyser's own thread (never the UI's), with its own MPD connection. The
    state is cached: a command goes to MPD only on a real change. Off waits VIS_OFF_DELAY after
    the analyser stops, so a quick trip between Active and Glance, or into a menu, doesn't flip it.
    If MPD has no output by that name, or refuses the command, switching stops and the output is
    left on (the old always-on arrangement) until the next start. MPD being unreachable (it starts
    after the UI) only means trying again a little later."""

    def __init__(self, switching=True, name=MPD_OUTPUT_VIS, client=None, log=None):
        self.switching = switching
        self.name = name
        self.mpd = client
        self.log = log or (lambda m: print(f"Visualiser output: {m}", flush=True))
        self.state = None        # True/False as last set (or read); None = unknown
        self.oid = None
        self.off_since = None
        self.retry_at = 0.0
        self.unreachable = 0
        self.commands = 0        # how many enable/disable commands went to MPD

    def _client(self):
        if self.mpd is None:
            self.mpd = MPDClient(timeout=1.5)
        return self.mpd

    def invalidate(self):
        """Something may have changed it behind our back (no samples while it should be on)."""
        self.state = None

    def want(self, on, now):
        """The analyser wants the samples (on) or not. Returns whether the output should be on."""
        if not self.switching:
            on = True                                   # always on: just make sure it is, once
        elif on:
            self.off_since = None
        else:
            self.off_since = self.off_since if self.off_since is not None else now
            on = now - self.off_since < VIS_OFF_DELAY   # keep it on for a while yet
        if on != self.state and now >= self.retry_at:
            self._set(on, now)
        return on

    def _set(self, on, now):
        try:
            mpd = self._client()
            if self.oid is None:
                for o in mpd.records("outputs", first="outputid"):
                    if o.get("outputname") == self.name:
                        self.oid = o["outputid"]
                        self.state = o.get("outputenabled") == "1"
                if self.oid is None:
                    raise LookupError(f"MPD has no output called {self.name!r}")
                if self.state == on:
                    self.unreachable = 0
                    return
            mpd.command(f"{'enableoutput' if on else 'disableoutput'} {self.oid}")
            self.commands += 1
            self.state, self.unreachable = on, 0
        except MPDError as e:
            if "unreachable" in str(e):
                self.unreachable += 1          # MPD not up yet, or restarting: try again soon
                self.retry_at = now + min(30.0, 2.0 * self.unreachable)
                self.state = None
                return
            self._give_up(f"MPD refused it ({e})", now)
        except LookupError as e:
            self._give_up(str(e), now)

    def _give_up(self, why, now):
        """Switching isn't reliable here: leave the output on, as it always used to be."""
        was = self.switching
        self.switching = False
        self.state = None
        self.retry_at = now + 2.0
        if was:
            self.log(f"switching off, leaving it on: {why}")


class Analyser:
    """Turns MPD's Visualiser copy of the music into spectrum strips, loudness and (for Scope)
    spectra, five times a second, in its own thread, only while `enabled` (the local Now Playing
    screen or Scope, animating). The thread wakes when `enabled` changes, never waits on audio
    longer than TAP_POLL without checking it, restarts a tap that goes quiet, and can be stopped
    (stop(), also run at exit) and started again. It closes the tap (ending arecord) as soon as
    it isn't wanted, and tells `vis` (VisualiserOutput) so MPD's output follows."""

    def __init__(self, threaded=True, vis=None):
        self.lock = threading.Lock()
        self.frames = deque(maxlen=HISTORY)
        self._enabled = False
        self.need_spec = False                       # only the Scope page needs full spectra
        self.win = None                              # the numpy parts: built with the first audio (_prepare)
        self.mom_n = max(1, round(0.4 * ANALYSIS_FPS))
        self.z = deque(maxlen=max(1, round(3 * ANALYSIS_FPS)))
        self.vis = vis
        self.wake = threading.Event()
        self.stopping = threading.Event()
        self.thread = None
        self.stats = {"blocks": 0, "taps": 0, "stalls": 0, "failures": 0}
        if threaded:
            self.start()
            atexit.register(self.stop)

    @property
    def enabled(self):
        return self._enabled

    @enabled.setter
    def enabled(self, on):
        on = bool(on)
        if on != self._enabled:
            self._enabled = on
            self.wake.set()

    def start(self):
        if self.thread is not None and self.thread.is_alive():
            return
        self.stopping.clear()
        self.thread = threading.Thread(target=self._run, name="analyser", daemon=True)
        self.thread.start()

    def stop(self, timeout=2.0):
        """Stop the worker (it closes its tap, ending arecord). It can be start()ed again."""
        self.stopping.set()
        self.wake.set()
        t = self.thread
        if t is not None and t is not threading.current_thread():
            t.join(timeout)
        return t is None or not t.is_alive()

    def _prepare(self):
        """Window, weights and band edges. Not in __init__: that runs before the first screen, and
        numpy isn't loaded until after it."""
        freqs = np.fft.rfftfreq(NFFT, 1 / RATE)
        self.kw = k_weight_power(freqs)
        self.kw2 = self.kw[:, None]
        self.spec_norm = (NFFT / 4) ** 2             # full-scale sine peak bin (Hann)
        win = np.hanning(NFFT).astype(np.float32)
        self.ms_norm = NFFT * float(np.sum(win ** 2))
        self.rows = log_bands(freqs, SPEC_ROWS)
        self.bands = log_bands(freqs, STRIP_BINS)
        self.buf = np.zeros((NFFT, 2), np.float32)
        self.work = np.empty((NFFT, 2), np.float32)  # the windowed copy the FFT reads
        self.win2 = win[:, None]
        self.absbuf = None                           # |block|, for the peaks
        self.layout = None
        self.P = None                                # power, its running sum, K-weighted: made to
        self.win = win                               # match the FFT's precision on the first block

    def history(self):
        with self.lock:
            return list(self.frames)

    def latest(self):
        with self.lock:
            return self.frames[-1] if self.frames else None

    def _cancelled(self):
        return not self._enabled or self.stopping.is_set()

    def _rest(self, secs):
        """Sleep, but wake at once for a change of `enabled` or stop()."""
        self.wake.wait(secs)
        self.wake.clear()

    def _run(self):
        src = None
        quiet_since = 0.0
        failures = 0
        try:
            while not self.stopping.is_set():
                want = self._enabled
                if self.vis is not None:
                    try:
                        self.vis.want(want, time.monotonic())
                    except Exception as e:  # noqa: BLE001 (never let MPD trouble stop the analyser)
                        print(f"Visualiser output: {e}", flush=True)
                if not want:
                    if src is not None:
                        src.close()
                        src = None
                    self._rest(0.25)
                    continue
                if src is None:
                    try:
                        src = open_audio_tap()
                        self.stats["taps"] += 1
                        quiet_since = time.monotonic()
                    except OSError:
                        failures += 1
                        self.stats["failures"] += 1
                        self._rest(min(5.0, 0.5 * failures))
                        continue
                try:
                    block = src.read_block(HOP, timeout=0.5, cancelled=self._cancelled)
                except TimeoutError:
                    block = None
                except Exception:  # noqa: BLE001 (arecord gone, device error: start again shortly)
                    src.close()
                    src = None
                    failures += 1
                    self.stats["failures"] += 1
                    self._rest(min(5.0, 0.5 * failures))
                    continue
                if block is None:
                    if self._enabled and time.monotonic() - quiet_since > TAP_STALL_SECS:
                        # no samples for a while: start the tap again, and have the output re-checked
                        self.stats["stalls"] += 1
                        src.close()
                        src = None
                        if self.vis is not None:
                            self.vis.invalidate()
                        self._rest(0.5)
                    continue
                quiet_since = time.monotonic()
                failures = 0
                if self._enabled:
                    self.process(block)
        finally:
            if src is not None:
                src.close()

    def process(self, block):
        if self.win is None:
            self._prepare()
        n = len(block)
        if n >= NFFT:                     # a block (HOP) is longer than the FFT: its last NFFT samples
            self.buf[:] = block[-NFFT:]
        else:
            self.buf[:-n] = self.buf[n:]
            self.buf[-n:] = block
        if self.absbuf is None or self.absbuf.shape != block.shape:
            self.absbuf = np.empty_like(block)
        np.abs(block, out=self.absbuf)
        # each channel's peak from its own column: a reduction down axis 0 of an (n, 2) array is
        # ten times slower, and was most of this function's time. (Exact: max ignores order.)
        peaks = (self.absbuf[:, 0].max(), self.absbuf[:, 1].max())
        np.multiply(self.buf, self.win2, out=self.work)
        X = np.fft.rfft(self.work, axis=0)
        layout = (X.real.dtype, X.shape, X.strides[0] < X.strides[1])
        if self.P is None or layout != self.layout:
            # The same precision and memory order as numpy gives the FFT (numpy 1.x: float64 and
            # column-major; 2.x: float32): the sums below then round exactly as they always did.
            self.layout = layout
            self.P = np.empty_like(X.real)
            self.P_im = np.empty_like(X.real)
            self.run_sum = np.empty_like(X.real)
            self.cs = np.zeros((X.shape[0] + 1, 2))  # float64, as vstack([zeros, cumsum]) gave
            self.pk = np.empty_like(X.real, dtype=np.result_type(X.real.dtype, self.kw.dtype))
        P = self.P
        np.square(X.real, out=P)
        np.square(X.imag, out=self.P_im)
        P += self.P_im
        self.cs[1:] = np.cumsum(P, axis=0, out=self.run_sum)
        cs = self.cs

        def band_db(lo_hi):
            lo, hi = lo_hi
            band = cs[hi] - cs[lo]   # total power in each log band (pink-flat for music)
            return 10 * np.log10(band / self.spec_norm + 1e-12)

        spec = band_db(self.rows) if self.need_spec else None
        strip = band_db(self.bands)
        pk = np.multiply(P, self.kw2, out=self.pk)
        total = pk[0] + 2 * pk[1:-1].sum(axis=0) + pk[-1]
        self.z.append(total / self.ms_norm)
        zs = np.array(self.z)
        mom = -0.691 + 10 * np.log10(zs[-self.mom_n:].mean(axis=0) + 1e-12)
        short = -0.691 + 10 * np.log10(zs.mean(axis=0) + 1e-12)

        f = Frame()
        f.spec = None if spec is None else (spec[:, 0].copy(), spec[:, 1].copy())
        v = np.clip((strip + 50) / 45, 0, 1) ** 1.5
        f.bins = (v[:, 0], v[:, 1])
        f.mom = (float(mom[0]), float(mom[1]))
        f.short = (float(short[0]), float(short[1]))
        f.peak = tuple(float(20 * math.log10(p + 1e-9)) for p in peaks)
        f.level = tuple(float(min(1.0, max(0.0, (m + 40) / 34))) for m in f.mom)
        self.stats["blocks"] += 1
        with self.lock:
            self.frames.append(f)


# ======================================================================
# Screen base: event-driven rendering
# ======================================================================
class Screen:
    version = 0               # bump when internal state changes

    def handle(self, kind, arg):
        return None

    def animates(self, snap, mode):
        return False

    def render_key(self, snap, now):
        """Anything that changes what's drawn. Same key -> no redraw."""
        return (snap.source, snap.has_track, snap.uri, snap.paused, id(snap.cover),
                snap.title, self.version, STATUS.get("wifi"), STATUS.get("output"),
                STATUS.get("locked"), STATUS.get("scrub"))

    def haptic(self):
        """(kind, positions, position, sync) for the ESP32 dial on this screen."""
        return ("scrub", 0, 0, 0)

    def haptic_extras(self):
        """{"marks": [...], "magnet": n} for this screen's dial, or None."""
        return None

    def dial_range(self, snap):
        """(positions, position) for walls that follow playback, or None."""
        return None


class NowPlaying:
    """The dial on the Now Playing screens. CLICKS (Settings > Scrub style): clicks through the song
    with walls at 0:00 and the end, and a fast spin coasts. SHUTTLE: a spring-back wheel, where a
    bigger twist scrubs faster and letting go stops."""
    now_playing = True

    def haptic(self):
        if self.app.settings.get("scrub_style") == "shuttle":
            return ("elastic", 0, 0, 0)
        return ("scrub", 0, 0, 0)

    def dial_range(self, snap):
        if self.app.settings.get("scrub_style") == "shuttle" or not snap.has_track or not snap.dur:
            return None
        step = max(1, self.app.settings.get("scrub_step", 2)) * 1000
        return int(snap.dur // step) + 1, int(min(snap.pos, snap.dur) // step)


def shuttle_speed(twist):
    """Shuttle gear for a twist of 0..100: 0 (stopped) in the middle, then 2x up to 32x."""
    for limit, speed in SHUTTLE_GEARS:
        if twist < limit:
            return speed
    return 32


def letter_marks(names):
    """Where each new first letter starts in a sorted list: the dial clicks harder there."""
    marks, last = [], None
    for i, n in enumerate(names):
        c = n.strip()[:1].upper()
        k = c if c.isalpha() else "#"
        if k != last:
            marks.append(i)
            last = k
    return marks[:64]


def wifi_icon(d, x, y, on):
    """12 x 10 Wi-Fi glyph at (x, y): three arcs, or arcs with a slash when offline."""
    for r in (3, 6, 9):
        d.arc((x + 6 - r, y + 10 - r, x + 6 + r, y + 10 + r), 225, 315, fill=BLACK, width=1)
    d.rectangle((x + 5, y + 9, x + 7, y + 10), fill=BLACK)
    if not on:
        d.line((x, y + 10, x + 12, y), fill=BLACK, width=1)


BT_RUNE = ("...#...",
           "...##..",
           "...#.#.",
           "#..#..#",
           ".#.#.#.",
           "..###..",
           ".#.#.#.",
           "#..#..#",
           "...#.#.",
           "...##..",
           "...#...")
BT_PIXELS = [(x, y) for y, row in enumerate(BT_RUNE) for x, c in enumerate(row) if c == "#"]


def bt_icon(d, x, y, fill=BLACK):
    """7 x 11 Bluetooth logo (the rune) at (x, y)."""
    d.point([(x + px, y + py) for px, py in BT_PIXELS], fill=fill)


class Icon:
    """A small picture a list can show in its value column instead of text."""

    def __init__(self, name, width, draw):
        self.name, self.width, self.draw = name, width, draw

    def __repr__(self):
        return f"<{self.name}>"


BT_LOGO = Icon("bluetooth", 7, lambda d, x, y, fill: bt_icon(d, x, y + 1, fill))


def output_value():
    """OUTPUT in the menus: the Bluetooth logo, or WIRED."""
    return BT_LOGO if STATUS.get("output") == "bluetooth" else "WIRED"


def lock_icon(d, x, y):
    """9 x 11 padlock: shown while the dial is pocket-locked."""
    d.arc((x + 1, y, x + 7, y + 8), 180, 360, fill=BLACK, width=1)
    d.line((x + 1, y + 4, x + 1, y + 5), fill=BLACK)
    d.line((x + 7, y + 4, x + 7, y + 5), fill=BLACK)
    d.rectangle((x, y + 5, x + 8, y + 11), fill=BLACK)


def status_icons(d, batt):
    """Battery, Wi-Fi, BT and lock, right to left along the footer. Returns the free space's right edge."""
    battery_icon(d, W - 30, H - 16, batt)
    x = W - 50
    if STATUS.get("wifi") is not None:
        wifi_icon(d, x, H - 17, STATUS["wifi"])
        x -= 18
    if STATUS.get("output") == "bluetooth":
        bt_icon(d, x + 3, H - 17)
        x -= 13
    if STATUS.get("locked"):
        lock_icon(d, x + 2, H - 18)
        x -= 12
    return x


def scrub_badge(d, cx, y):
    """'FF 8x' / 'REW 4x' in a black box while auto-scrubbing."""
    text = STATUS.get("scrub")
    if not text:
        return
    w = tlen(F_SBOLD, text) + 12
    d.rectangle((cx - w / 2, y, cx + w / 2, y + 15), fill=BLACK)
    d.text((cx - w / 2 + 6, y + 1), text, font=F_SBOLD, fill=WHITE)


def footer(d, snap, batt, glyph=True):
    d.line((0, H - 22, W - 1, H - 22), fill=BLACK)
    right = status_icons(d, batt)
    if snap.has_track:
        text = f"{'||' if snap.paused else '>'} {snap.title}" if glyph else snap.title
        d.text((8, H - 17), fit(text, F_TINY, right - 12), font=F_TINY, fill=BLACK)


# ======================================================================
# Spotify screen (simple): big cover, info, progress
# ======================================================================
class SpotifyScreen(NowPlaying, Screen):
    def __init__(self, app):
        self.app = app
        self.static_key = None
        self.static = None
        self.playhead = 8

    def bird_layer(self, img, now):
        """The currawong: on the twig at the playhead, or on its branch when nothing's playing."""
        bird = self.app.bird
        if not bird:
            return None
        if self.app.snap.has_track and not self.app.paused_idle:
            return bird.draw_now(img, now, self.playhead)
        return bird.draw_idle(img, now)

    def handle(self, kind, arg):
        if kind == "rot":
            self.app.player.seek_by(self.app.snap, arg * self.app.settings.get("scrub_step", 2) * 1000)
        elif kind == "press" and arg == "enc_sw":
            return main_menu(self.app)
        elif kind == "press" and arg == "back" and not self.app.lock.locked(time.monotonic()):
            return main_menu(self.app)  # BACK opens the menu here too (not while pocket-locked)
        return None

    def render_key(self, snap, now):
        return super().render_key(snap, now) + (int(snap.pos // 1000), int(snap.dur // 1000),
                                                self.app.battery.state(), snap.playing, self.app.paused_idle)

    def _static_layer(self, snap):
        key = (snap.has_track, snap.uri, id(snap.cover), snap.paused, snap.source, snap.reachable,
               STATUS.get("resuming"), bool(self.app.bird), snap.playing, self.app.paused_idle)
        if key == self.static_key:
            return self.static
        self.static_key = key
        img = Image.new("1", (W, H), WHITE)
        d = Draw(img)
        idle = self.app.paused_idle
        if (snap.has_track and not idle) or not self.app.bird:  # idle: paper, for the bird's branch
            img.paste(snap.cover["large"] if snap.cover else dots(W, W), (0, 0))
        d.line((0, W, W - 1, W), fill=BLACK)
        if idle:
            d.text((8, W + 10), "PAUSED", font=F_BIG, fill=BLACK)
            d.text((8, W + 36), fit(snap.title, F_BODY, W - 16), font=F_BODY, fill=BLACK)
            d.text((8, W + 54), fit(snap.artists, F_SMALL, W - 16), font=F_SMALL, fill=BLACK)
            d.text((8, W + 82), "Play carries on from here.", font=F_SMALL, fill=BLACK)
        elif snap.has_track:
            y = W + 8
            for line in wrap(snap.title, F_BIG, W - 16, 2):
                d.text((8, y), line, font=F_BIG, fill=BLACK)
                y += 20
            d.text((8, y + 2), fit(snap.artists, F_BODY, W - 16), font=F_BODY, fill=BLACK)
            d.text((8, y + 20), fit(snap.album, F_SMALL, W - 16), font=F_SMALL, fill=BLACK)
        elif STATUS.get("resuming"):
            d.text((8, W + 10), "RESUMING", font=F_BIG, fill=BLACK)
            for n, line in enumerate(wrap(STATUS["resuming"], F_BODY, W - 16, 2)):
                d.text((8, W + 36 + n * 18), line, font=F_BODY, fill=BLACK)
            if snap.source == "spotify" or getattr(self.app.player, "hold", None) == "spotify":
                d.text((8, W + 76), "Once Spotify signs in on Wi-Fi.", font=F_SMALL, fill=BLACK)
        else:
            d.text((8, W + 10), "NOT PLAYING", font=F_BIG, fill=BLACK)
            if snap.reachable:
                for n, line in enumerate(["Pick Currawong in Spotify,", "or choose music from", "LIBRARY in the menu."]):
                    d.text((8, W + 38 + n * 16), line, font=F_SMALL, fill=BLACK)
            else:
                d.text((8, W + 38), "Waiting for the players…", font=F_SMALL, fill=BLACK)
        d.line((0, H - 22, W - 1, H - 22), fill=BLACK)
        if snap.has_track:
            d.text((8, H - 17), f"{'Playing' if snap.playing else 'Paused'} · {snap.fmt}", font=F_TINY, fill=BLACK)
        elif self.app.bird:
            d.text((8, H - 17), "Idle", font=F_TINY, fill=BLACK)
        self.static = img
        return img

    def render(self, now, snap, mode):
        img = self._static_layer(snap).copy()
        d = Draw(img)
        if snap.has_track and not self.app.paused_idle:
            self.playhead = twig(img, snap.pos / snap.dur if snap.dur else 0.0)
            d.text((8, 350), mmss(snap.pos), font=F_SMALL, fill=BLACK)
            rem = "-" + mmss(max(0, snap.dur - snap.pos))
            d.text((W - 8 - tlen(F_SMALL, rem), 350), rem, font=F_SMALL, fill=BLACK)
            scrub_badge(d, W / 2, 348)
        status_icons(d, self.app.battery)
        return img


# ======================================================================
# Local Now Playing (visual): cover + info, spectrum strips, times
# ======================================================================
SCROLL = 4                # px per frame (5 fps x 4 px = 20 px per second)
STRIP_W = STRIP_BINS      # 40
BAYER = [[0, 8, 2, 10], [12, 4, 14, 6], [3, 11, 1, 9], [15, 7, 13, 5]]
THRESH = [[(v + 0.5) / 16 for v in row] for row in BAYER]

COVER = 104
COVER_X, COVER_Y = 6, 6
INFO_X = 116
INFO_W = W - INFO_X - 6
HDR_BOTTOM = 117
LOW_Y = 122
LS_X = 2
RS_X = W - 2 - STRIP_W                  # 198
STRIP_Y = LOW_Y + 2
AXIS_Y = H - 16
WF_H = AXIS_Y - 2 - STRIP_Y
C_L = LS_X + STRIP_W + 1                # 43
C_R = RS_X - 2                          # 196
C_MID = (C_L + C_R) // 2
BAR_X0, BAR_X1 = C_MID - 5, C_MID + 4
BAR_Y0, BAR_Y1 = LOW_Y + 98, AXIS_Y - 22
FAST_RANGES = ((LS_X, LS_X + STRIP_W), (RS_X, RS_X + STRIP_W))


class VWaterfall:
    """Vertical spectrogram strip, newest rows at the bottom, plus a magnitude trace."""

    def __init__(self, height, mirror):
        self.h = height
        self.img = Image.new("1", (STRIP_W, height), WHITE)
        self.mirror = mirror  # True: bass on the right edge (inner side of the left strip)
        self.row = 0
        self.last_x = None

    def push(self, vals, level):
        im, h = self.img, self.h
        im.paste(im.crop((0, SCROLL, STRIP_W, h)), (0, 0))
        v = np.asarray(vals, dtype=np.float32)
        if self.mirror:
            v = v[::-1]
        rows = (self.row + np.arange(SCROLL)) & 3
        ink = (v[None, :] > TABLES.THRESH_TILE[rows]) & (v[None, :] > 0.03)
        im.paste(Image.fromarray(~ink), (0, h - SCROLL))
        self.row += SCROLL
        # Magnitude trace: draw just the newest segment; it scrolls up with the strip
        x = (1 - level) * (STRIP_W - 1) if self.mirror else level * (STRIP_W - 1)
        if self.last_x is not None:
            d = ImageDraw.Draw(im)
            seg = (self.last_x, h - 1 - SCROLL, x, h - 1)
            d.line(seg, fill=WHITE, width=3)
            d.line(seg, fill=BLACK, width=1)
        self.last_x = x

    def composite(self):
        return self.img
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
